ycpss91255/digital_twin/Reference/Capacitor/SMD Capacitor.jpg

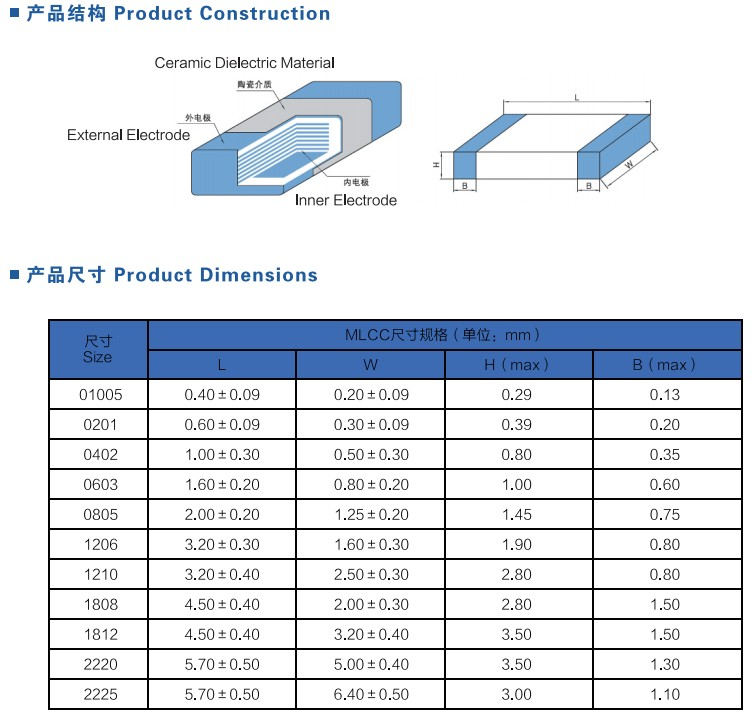
Reference/Capacitor/SMD Capacitor.jpg
