ycpss91255/digital_twin/Reference/header/2.54牛角.jpg

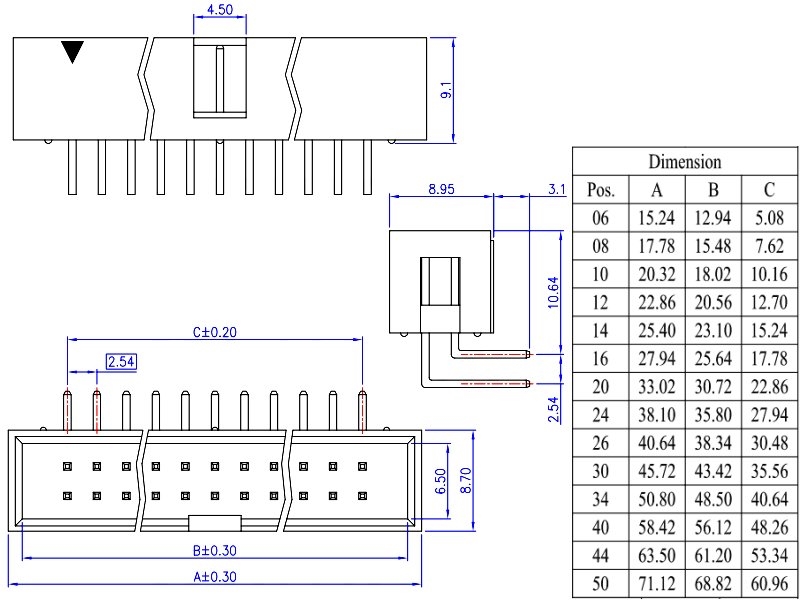
Reference/header/2.54牛角.jpg
