ycpss91255/digital_twin/Reference/header/KF301-2P.jpg

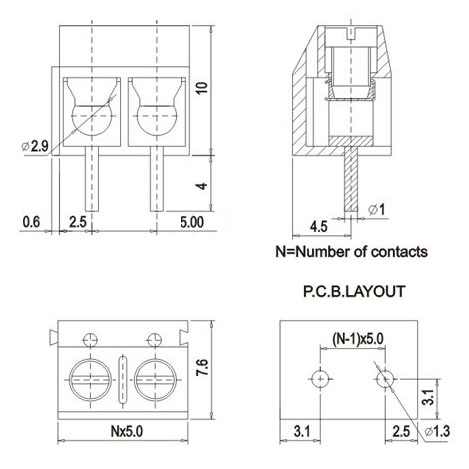
Reference/header/KF301-2P.jpg
