ycpss91255/digital_twin/Reference/Power Supply/XH-M401 非隔離型DC-DC降壓模組/尺寸圖2.png

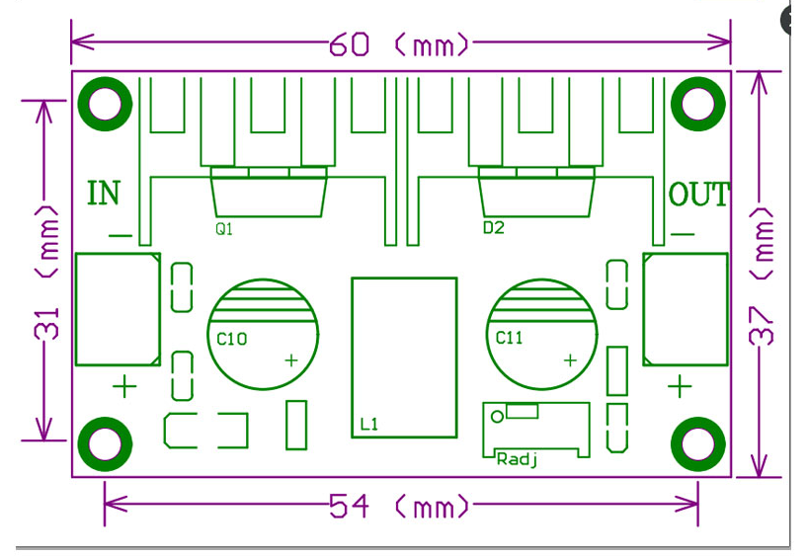
Reference/Power Supply/XH-M401 非隔離型DC-DC降壓模組/尺寸圖2.png
