ycpss91255/digital_twin/Output_PCB/Module_maybe_v2/Main_v1/BOM/Bill of Materials-Main.xlsx

Comment | Description | Designator | Footprint | LibRef | Quantity
220uF | -45℃~+105℃ 2000hrs@105℃ 220uF 7.7mm 25V 6.3mm ±20% SMD,6.3x7.7mm Aluminum Electrolytic Capacitors - SMD ROHS | C1, C2, C7, C8, C11, C13, C14, C19, C20, C21, C22, C29, C30 | VZT221M1ETR-0607 | Cap Pol1 | 13
0.1uF | 50V 100nF X7R ±10% 1210 Multilayer Ceramic Capacitors MLCC - SMD/SMT ROHS | C3, C4, C9, C10, C15, C16, C17, C18, C25, C26, C27, C28, C33, C34, C35, C36 | 1210B104K500NT | Cap Semi | 16
10F | CAPACITOR 10F -10% +30% 5.5V T/H | C5, C6 | SUPPYCAP-DIP_L33.0_W16.5 | Cap Pol1 | 2
0.1uF | 25V 100nF X7R ±10% 0603 Multilayer Ceramic Capacitors MLCC - SMD/SMT ROHS | C12, C23, C24, C31, C32 | CL10B104KA8NNNC | Cap Semi | 5
LED(G) | Green-yellow 0603 Light Emitting Diodes (LED) RoHS | D1, D2 | BL-HG036D-AV-TRB | LED0 | 2
De0-Nano | DE0-Nano | De0 | DE0-Nano | De0-Nano | 1
De10-Nano | De10-Nano | De10 | De10-Nano | De10-Nano | 1
5A Fuse Holder | 01550900M (Fuse Holder) SMD,9.73x5.03mm Fuse Holders ROHS ----- 0451005.MRL (Fuse) FastBlow 50A SMD Fuse 5A 5.566 12.5mΩ SMD Fuses ROHS | F1 | SMD Fuses Holder | Fuse 1 | 1
10A Fuse Holder | 01550900M (Fuse Holder) SMD,9.73x5.03mm Fuse Holders ROHS ----- 0451010.MRL (Fuse) FastBlow 50A SMD Fuse 10A 26.46 5.6mΩ SMD Fuses ROHS | F2 | SMD Fuses Holder | Fuse 1 | 1
4A Fuse Holder | 01550900M (Fuse Holder) SMD,9.73x5.03mm Fuse Holders ROHS ----- 0451004.MRL (Fuse) FastBlow 50A SMD Fuse 4A 3.152 16mΩ SMD Fuses ROHS | F3, F4 | SMD Fuses Holder | Fuse 1 | 2
DC-005-T25 | Shrouded DC Power Receptacle -10℃~+60℃ 2.5mm 6.3mm 3A 30V Plugin AC/DC Power Connectors ROHS | J1 | DC-005-T25 | PWR2.5 | 1
M3 Hole | M3 Hole | MH1, MH2, MH3, MH4, MH5, MH6, MH7, MH8, MH9 | M3 Hole | M3_Hole | 9
Header 2 | XT60PW-F 500V 45A Through Hole Power Connectors ROHS | P1 | XT60PW-F | Header 2 | 1
Header 2 | 1x2P XH 1 2.5mm 2 Brass Plugin,P=2.5mm Wire To Board / Wire To Wire Connector ROHS | P2, P3, P4 | B2B-XH-A(LF)(SN) | Header 2 | 3
Header 3 | 1x3P XH 1 2.5mm 3 Brass Plugin,P=2.5mm Wire To Board / Wire To Wire Connector ROHS | P5 | B3B-XH-A(LF)(SN) | Header 3 | 1
MPU9250 | 9DOF, 3 Axis Gyro, Acceleration, Magmetic | P6 | MPU9250 | MPU9250 | 1
Header 7 | 3A Straight Square Pins 2.5mm 6mm -40℃~+105℃ 1 7 3mm 2.54mm Black 1x7P Plugin,P=2.54mm Pin Headers ROHS | P7, P9 | KH-2.54FH-1X7P-H8.5 | Header 7 | 2
Header 4 | 3A Straight Square Pins 2.5mm 6mm -40℃~+105℃ 1 4 3mm 2.54mm Black 1x4P Plugin,P=2.54mm Pin Headers ROHS | P8, P10 | KH-2.54FH-1X4P-H8.5 | Header 4 | 2
Header 12 | 3A Straight Square Pins 2.5mm 6mm -40℃~+105℃ 1 12 3mm 2.54mm Black 1x12P Plugin,P=2.54mm Pin Headers ROHS | P11, P12 | KH-2.54FH-1X12P-H8.5 (Pad Linked) | Header 12 | 2
Header 6 | 1x6P XH 1 2.5mm 6 Brass Plugin,P=2.5mm Wire To Board / Wire To Wire Connector ROHS | P13, P14, P15, P16 | B6B-XH-A(LF)(SN) | Header 6 | 4
150k | 100mW 50V ±1% ±100ppm/℃ -55℃~+155℃ 150kΩ 0603 Chip Resistor - Surface Mount ROHS | R1, R3 | RS-03K1503FT | Res1 | 2
1k | 100mW 50V ±1% ±100ppm/℃ -55℃~+155℃ 150kΩ 0603 Chip Resistor - Surface Mount ROHS | R2, R5, R6 | RS-03K1503FT | Res1 | 3
12 | Metal Oxide Resistors 12Ω 3W ±700ppm/℃ ±5% Axial Leaded Through Hole Resistors ROHS | R4 | MOF3WS-12Ω±5%T | Res1 | 1
Rasbperry PI 4 |  | RPi1 | Raspberry Pi 4 | Rasbperry PI 4 | 1
Motor EMS | JNQ032 (Header) 30A Short Connection Quick connect terminal Plugin Cold-pressed?Terminals ROHS ----- RT-S02-113-R42BR (Switch) Through Hole Rocker Switches ROHS | S1 | JNQ032 | SW-SPST | 1
Digital EMS | Cylindrical button handle 125V -25℃~85℃ SPDT PCPin 40000 3A Plugin Toggle Switches ROHS | S2 | ST-0-102-C03-N003-RS | SW-SPDT | 1
FPGA_Re | 6.2mm 3.1mm Round Button 50mA Brick nogging 6.5mm SPST 12V SMD Tactile Switches ROHS | S3 | SKHMQLE010 | SW-SPST | 1
RPi_Re | 6.2mm 3.1mm Round Button 50mA Brick nogging 6.5mm SPST 12V SMD Tactile Switches ROHS | S4 | SKHMQKE010 | SW-SPST | 1
XL4015 Module | XL4015E1 (Module) Step-down type TO-263-5 DC-DC Converters ROHS ----- A2541HWV-2x2P (Header) 2.54mm 2.54mm Gold Brass Straight 2x2P 4 2 Plugin,P=2.54mm Female Headers ROHS | T1 | XL4015 Voltage Regulator Module | Non-isolated Voltage regulator | 1
XL4016 Module | NO Step-down type 1 Step-down 1.25V~36V 8V~40V 8A 180kHz TO-220-5 DC-DC Converters ROHS | T2 | XH-M401 Voltage Regulator Module | Non-isolated Voltage regulator | 1
3P3 Voltage regulator | 3A Non-isolated Voltage Regulator | T3 | Small Voltage regulator module | Non-isolated Voltage regulator | 1
HSM3214 | 30V 10A 12mΩ@10V,8A 1.5W 2.5V@250μA 2 N-Channel SOP-8 MOSFETs ROHS | U1, U2 | HSM3214 | HSM3214 | 2
