ycpss91255/digital_twin/Output_PCB/Module_maybe_v2/Main_v1/ExportSTEP/Main.step

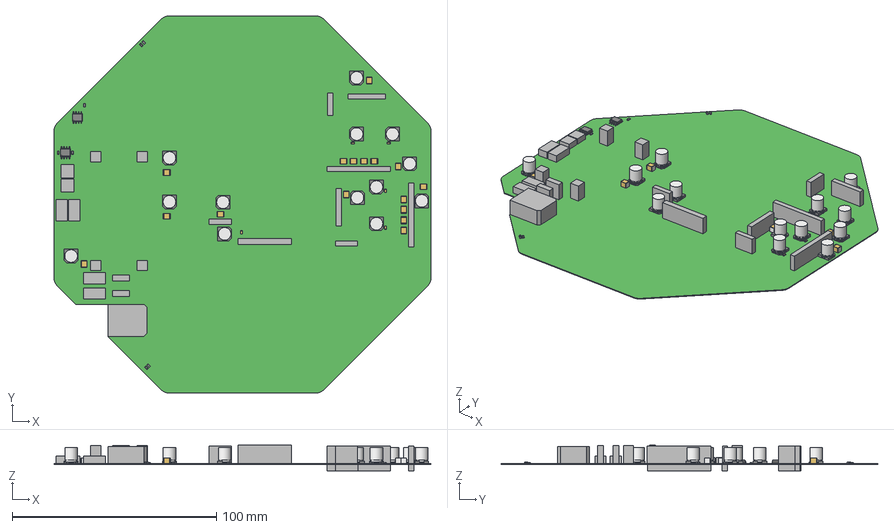
[picture p9: CAD file, 2023-05-25]
Output_PCB/Module_maybe_v2/Main_v1/ExportSTEP/Main.step
184.8 x 184.8 x 12.7 mm
Open_CASCADE_STEP_translator_6.8_25.1.1 x 13
Open_CASCADE_STEP_translator_6.8_25.2.1 x 13
Open_CASCADE_STEP_translator_6.8_25.3.1 x 13
lead x 26
Open_CASCADE_STEP_translator_6.8_7.1.1 x 16
Open_CASCADE_STEP_translator_6.8_7.1.2 x 16
Open_CASCADE_STEP_translator_6.8_7.2.1 x 16
Open_CASCADE_STEP_translator_6.8_3.1.1 x 5
Open_CASCADE_STEP_translator_6.8_3.1.2 x 5
Open_CASCADE_STEP_translator_6.8_3.2.1 x 5
Open_CASCADE_STEP_translator_6.8_14.1.1 x 2
Open_CASCADE_STEP_translator_6.8_14.1.2 x 2
Open_CASCADE_STEP_translator_6.8_14.2.1 x 2
Extruded x 27
Mid_Body x 5
Open_CASCADE_STEP_translator_6.8_10.2.1 x 10
Mark x 5
Open_CASCADE_STEP_translator_6.8_17.1 x 2
Open_CASCADE_STEP_translator_6.8_17.2.1 x 2
Leader x 16
