ycpss91255/digital_twin/Output_PCB/integration_v1/Folder Structure/ExportSTEP/Top.step

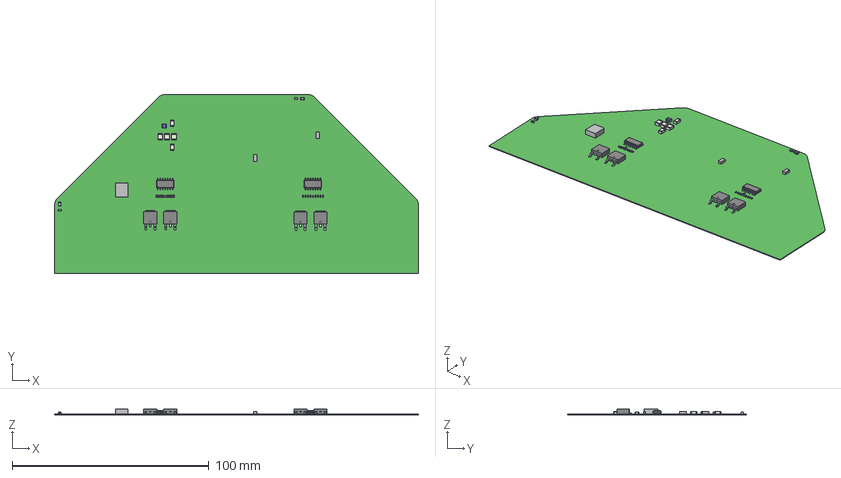
[picture p10: CAD file, 2023-02-23]
Output_PCB/integration_v1/Folder Structure/ExportSTEP/Top.step
184.8 x 90.9 x 3.03 mm
Extruded x 32
Open_CASCADE_STEP_translator_6.8_12.1 x 4
Open_CASCADE_STEP_translator_6.8_12.2.1 x 36
Lead x 8
Trimmed_Lead x 4
tab x 4
Mid_Body x 16
Mark x 16
Open_CASCADE_STEP_translator_6.8_20.1 x 2
Open_CASCADE_STEP_translator_6.8_20.2.1 x 2
Leader x 28
term1
term2
