ycpss91255/digital_twin/Power/USB-C Power/Project Outputs for USB-C Power/v1/ExportSTEP/USB-C Power.step

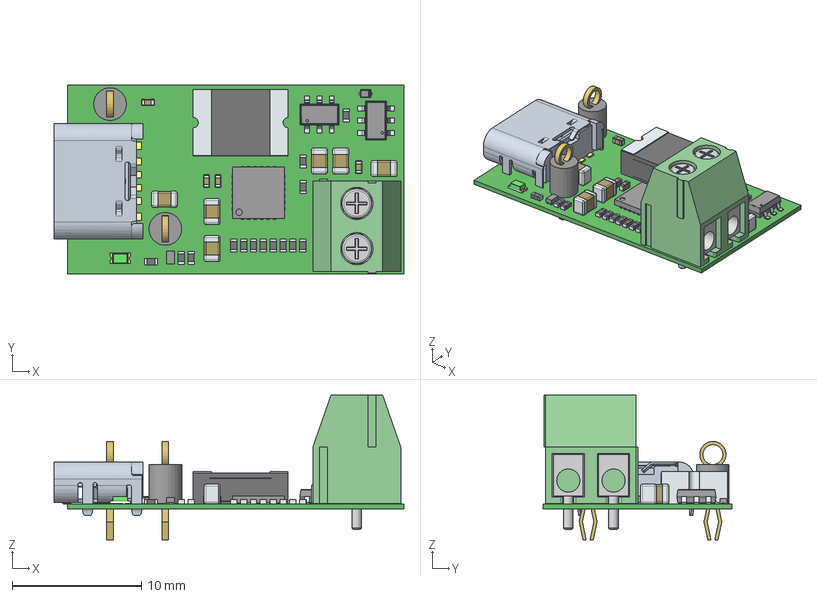
[picture p12: CAD file, 2023-06-17]
Power/USB-C Power/Project Outputs for USB-C Power/v1/ExportSTEP/USB-C Power.step
27.1 x 14.6 x 11.2 mm
PinsArrayLR x 3
term1 x 14
term2 x 14
Pins
Screw_Terminal_Block_3.5mm_2-way
ThermalPin
PinsArrayTB
Rect6
Rect7
solidBody
Terminal
PinKIdent
PinK
PinA
