ycpss91255/digital_twin/Output_PCB/Module_maybe_v2/MotorCtrl_v1/ExportSTEP/MotorCtrl.step

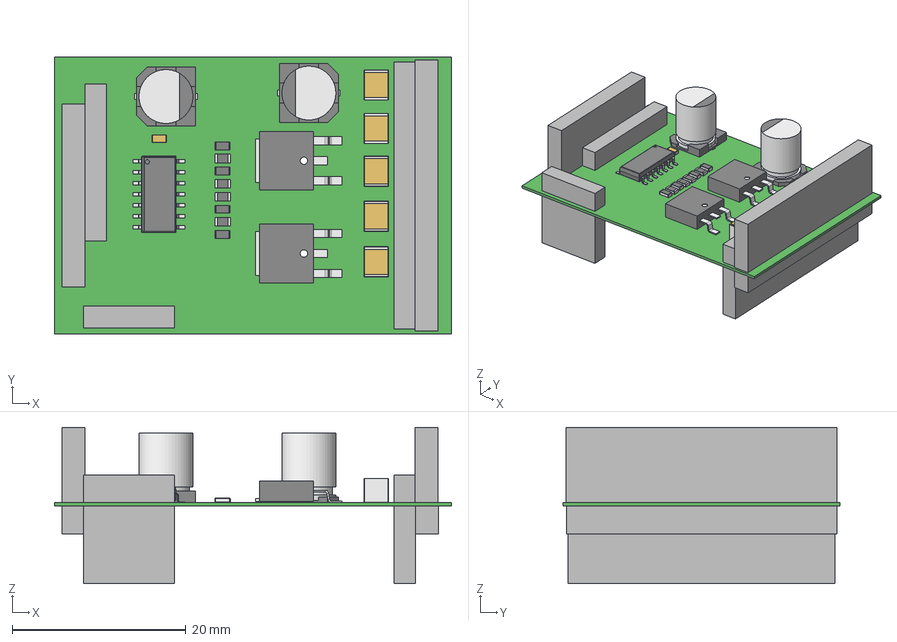
[picture p13: CAD file, 2023-05-25]
Output_PCB/Module_maybe_v2/MotorCtrl_v1/ExportSTEP/MotorCtrl.step
45.7 x 31.9 x 18.0 mm
Open_CASCADE_STEP_translator_6.8_7.1.1 x 5
Open_CASCADE_STEP_translator_6.8_7.1.2 x 5
Open_CASCADE_STEP_translator_6.8_7.2.1 x 5
Open_CASCADE_STEP_translator_6.8_12.1 x 2
Open_CASCADE_STEP_translator_6.8_12.2.1 x 2
Lead x 4
Trimmed_Lead x 2
tab x 2
Open_CASCADE_STEP_translator_6.8_20.1
Open_CASCADE_STEP_translator_6.8_20.2.1
Leader x 14
Open_CASCADE_STEP_translator_6.8_25.1.1 x 2
Open_CASCADE_STEP_translator_6.8_25.2.1 x 2
Open_CASCADE_STEP_translator_6.8_25.3.1 x 2
lead x 4
Open_CASCADE_STEP_translator_6.8_3.1.1
Open_CASCADE_STEP_translator_6.8_3.1.2
Open_CASCADE_STEP_translator_6.8_3.2.1
Extruded x 10
Mid_Body x 8
Open_CASCADE_STEP_translator_6.8_1.2.1 x 8
Mark x 8
Open_CASCADE_STEP_translator_6.8_2.2.1 x 8
