ycpss91255/digital_twin/old_data/Reference/partition_Temp.DXF

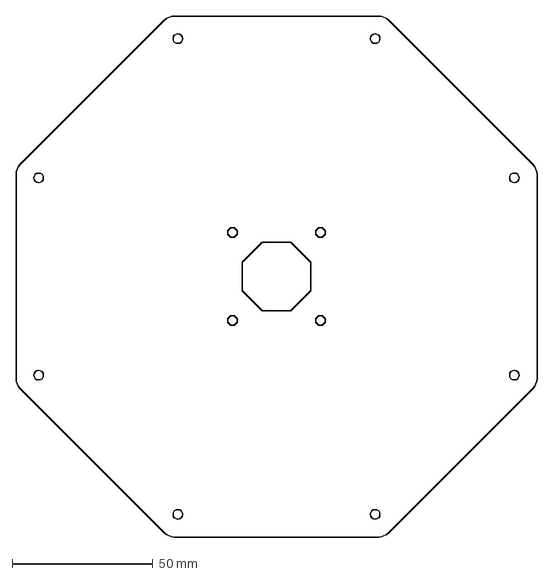
[picture p14: CAD file, 2023-02-23, an earlier design]
old_data/Reference/partition_Temp.DXF
184.8 x 184.8 mm
