ycpss91255/digital_twin/(list of files, cad)

Other CAD files:
OWMR/Project Outputs for OWMR/Output_v1/Folder Structure/ExportSTEP/Top.step
old_data/Reference/partition_Temp_20mm.DWG
