ycpss91255/digital_twin/Output_PCB/Module_maybe_v2/Main_v1/Schematic Print/Schematic Prints.PDF

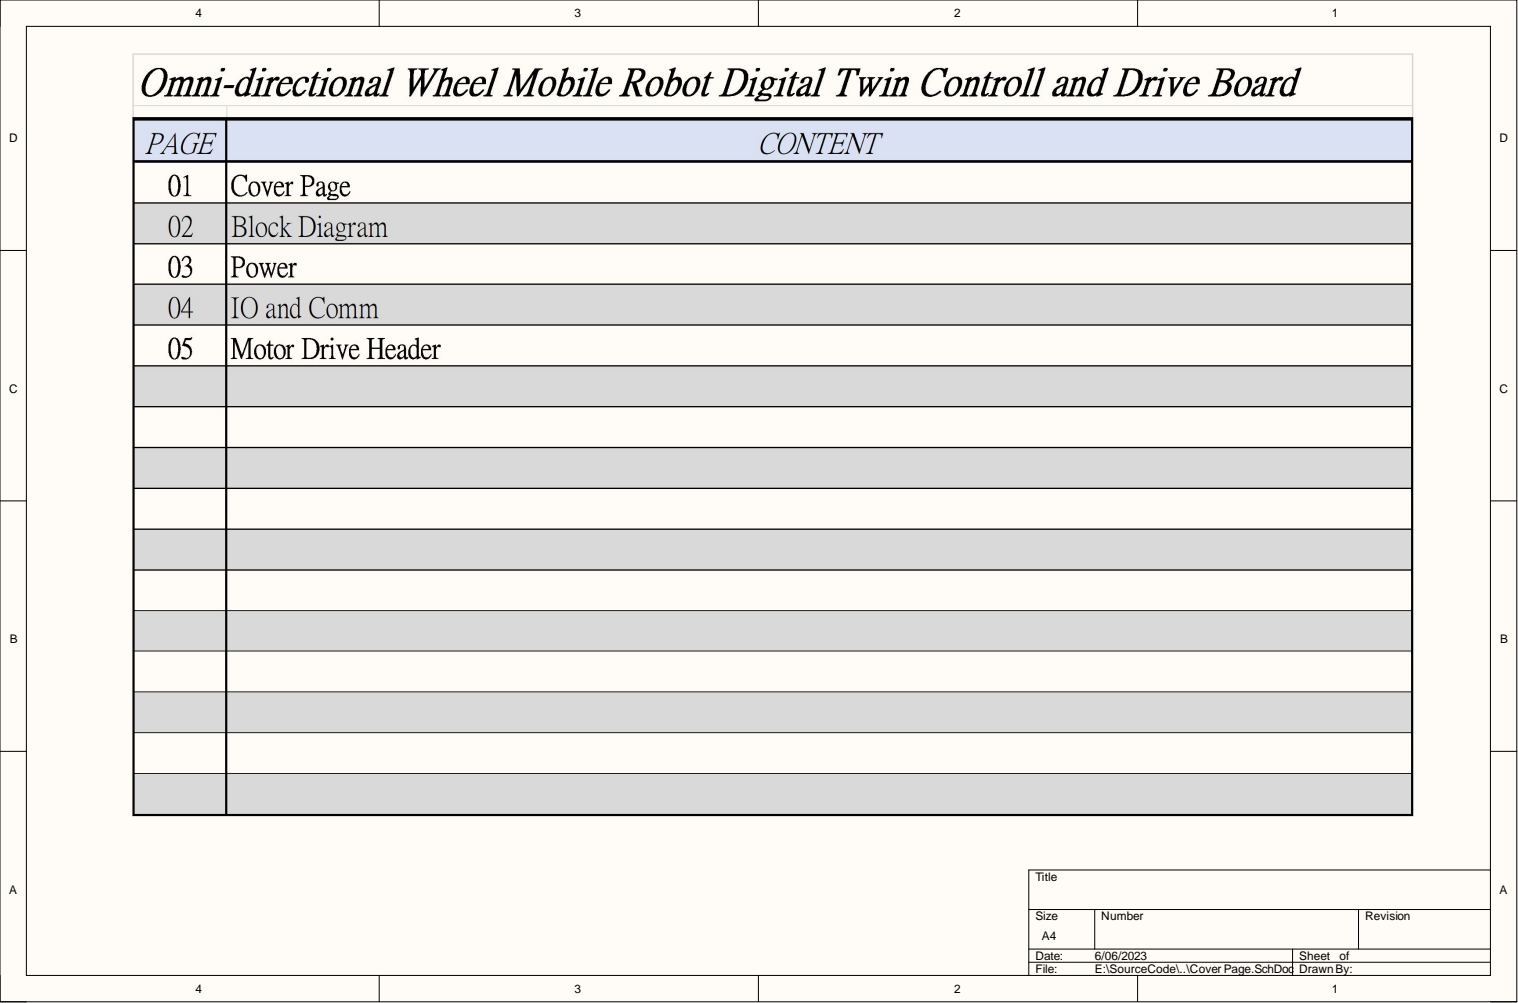
[picture p15: page 1]

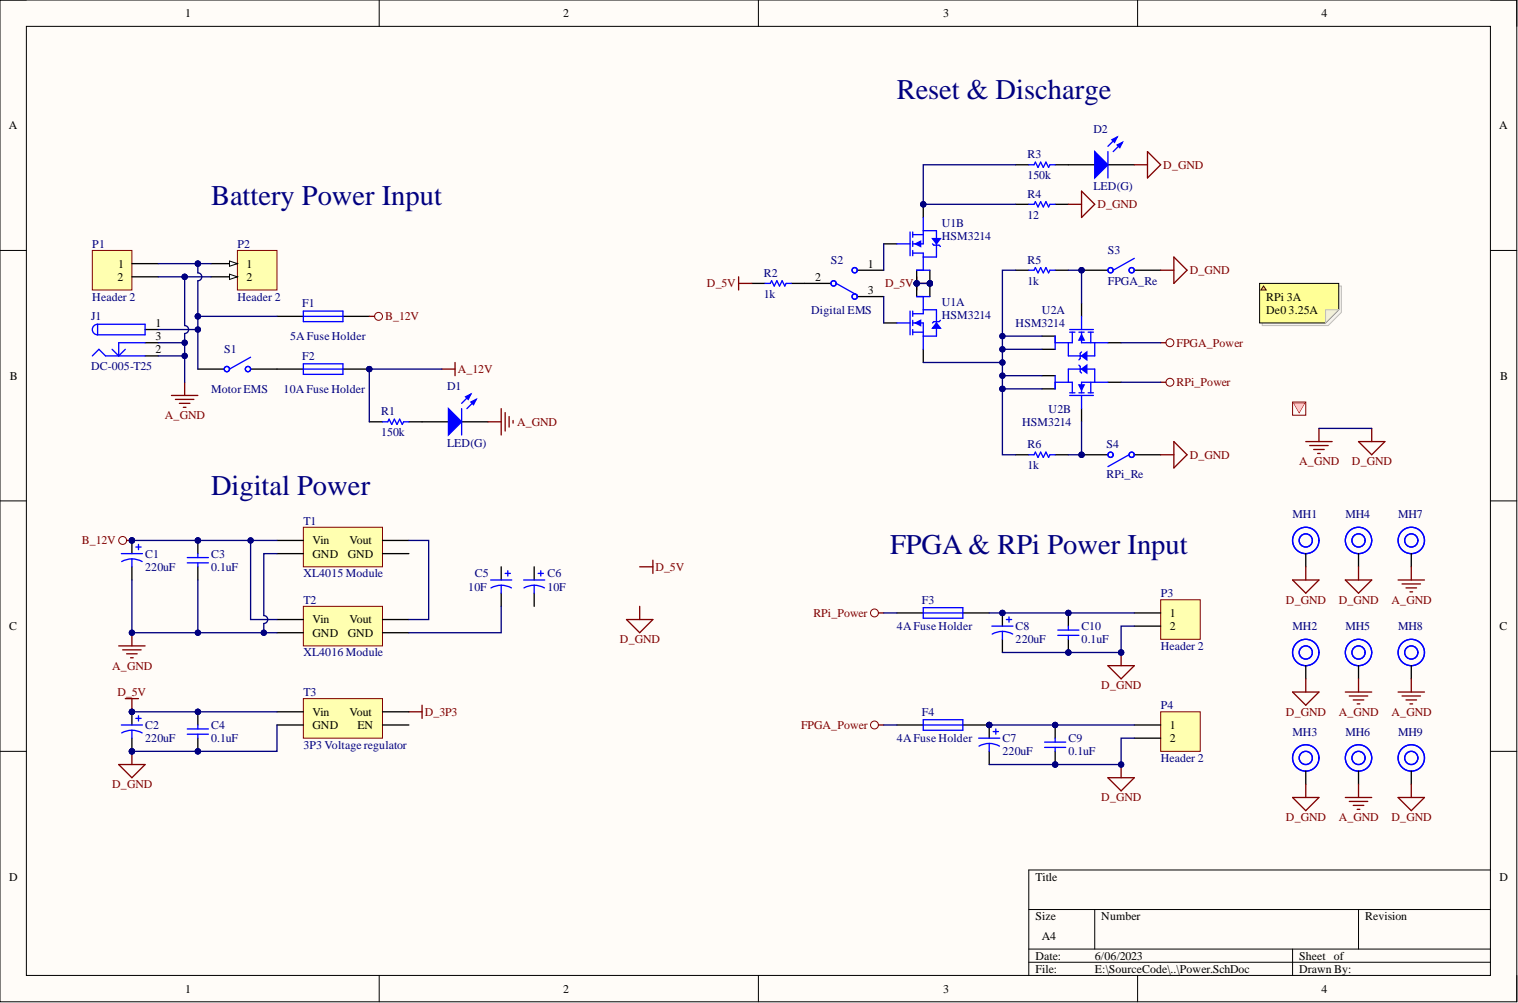
[picture p16: page 2]

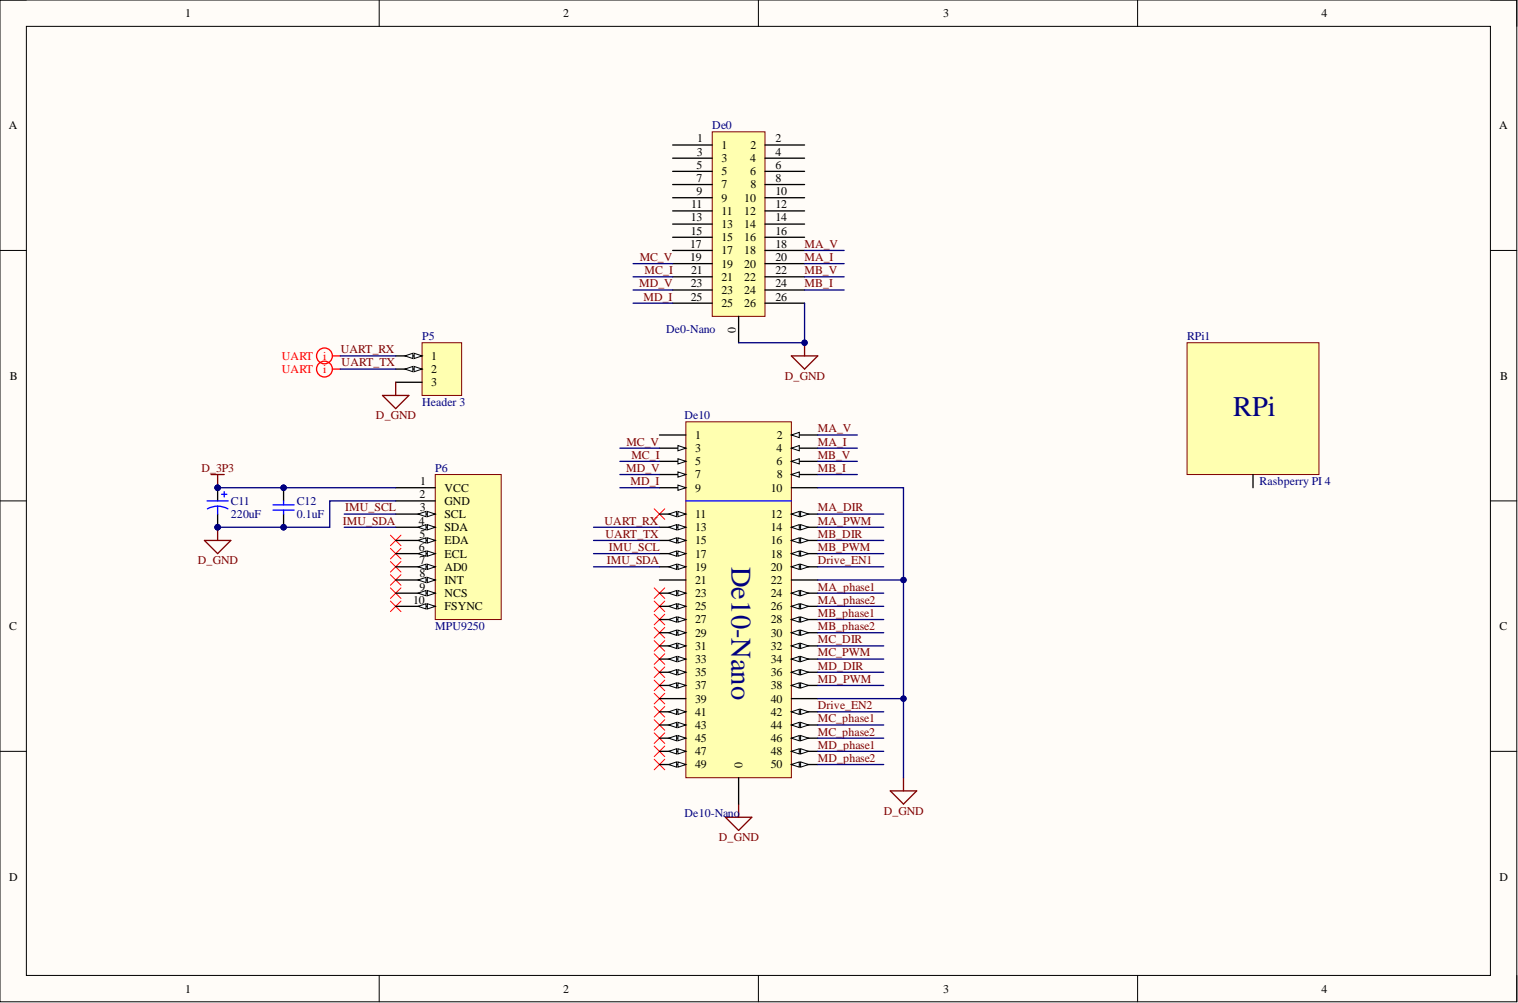
[picture p17: page 3]

MA _ D IR MA _PW M MB_ D IR MB_PW M Dri ve_ E N 1

MA _ p h a s e 1 MA _ p h a s e 2 MB_ p has e 1 MB_ p has e 2 MC_ D IR MC_PW M MD _ D IR MD _PW M

Dri ve_ E N 2 MC_ p has e 1 MC_ p has e 2 MD _ p h a s e 1 MD _ p h a s e 2

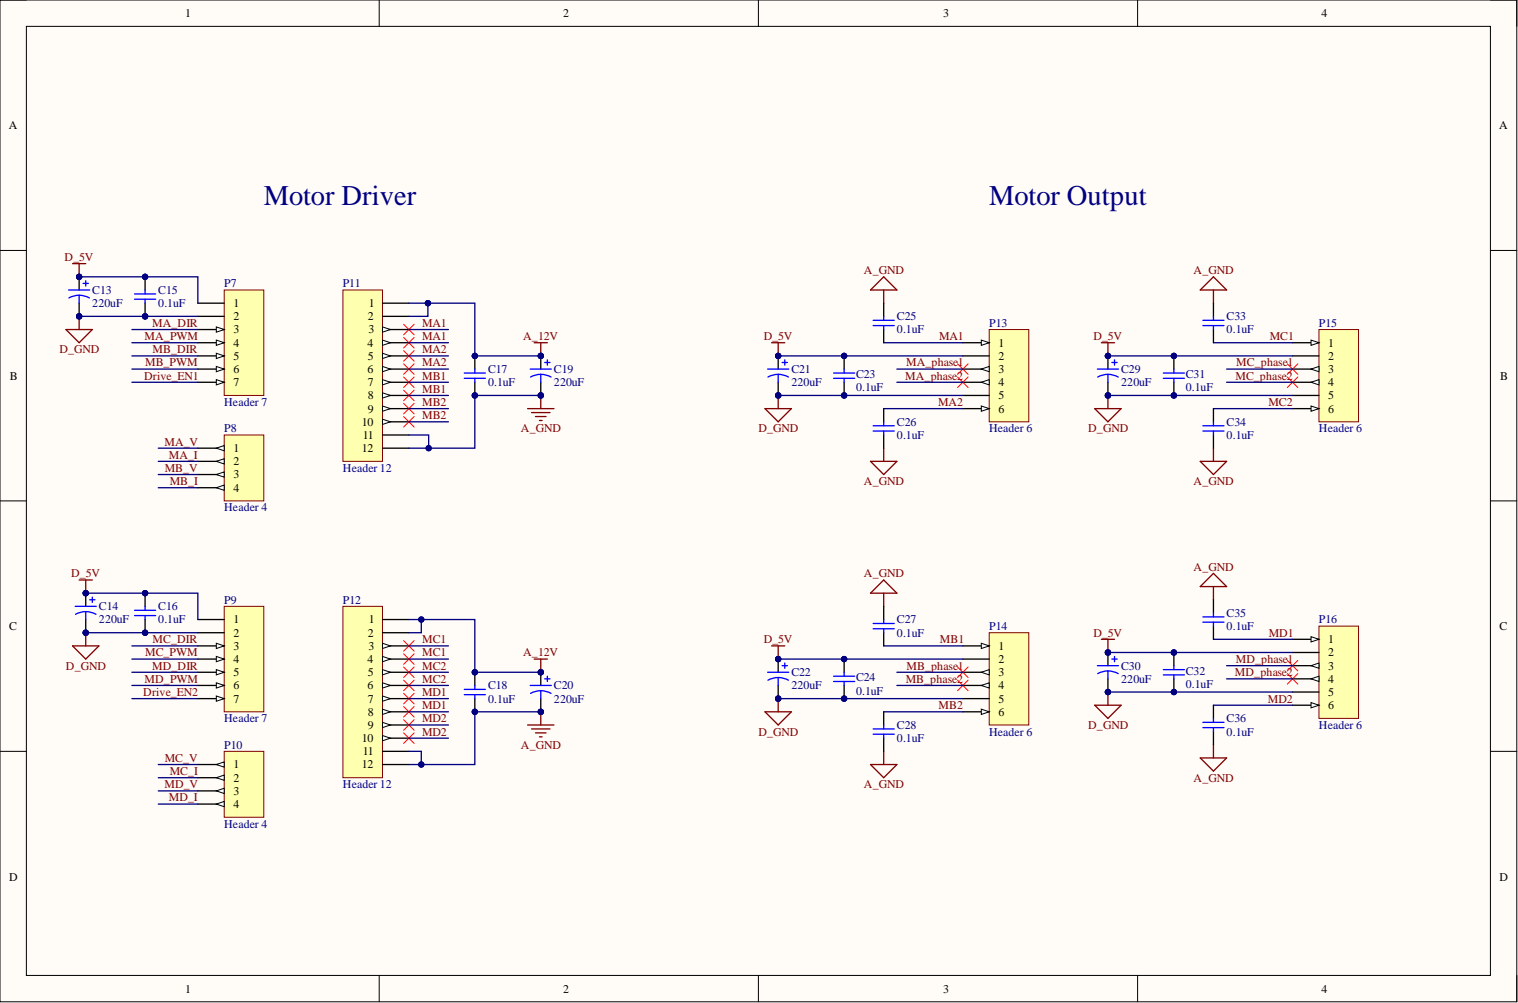
[picture p18: page 4]
