ycpss91255/digital_twin/Power/USB-C Power/Project Outputs for USB-C Power/v1/PDF/Schematic Prints.PDF

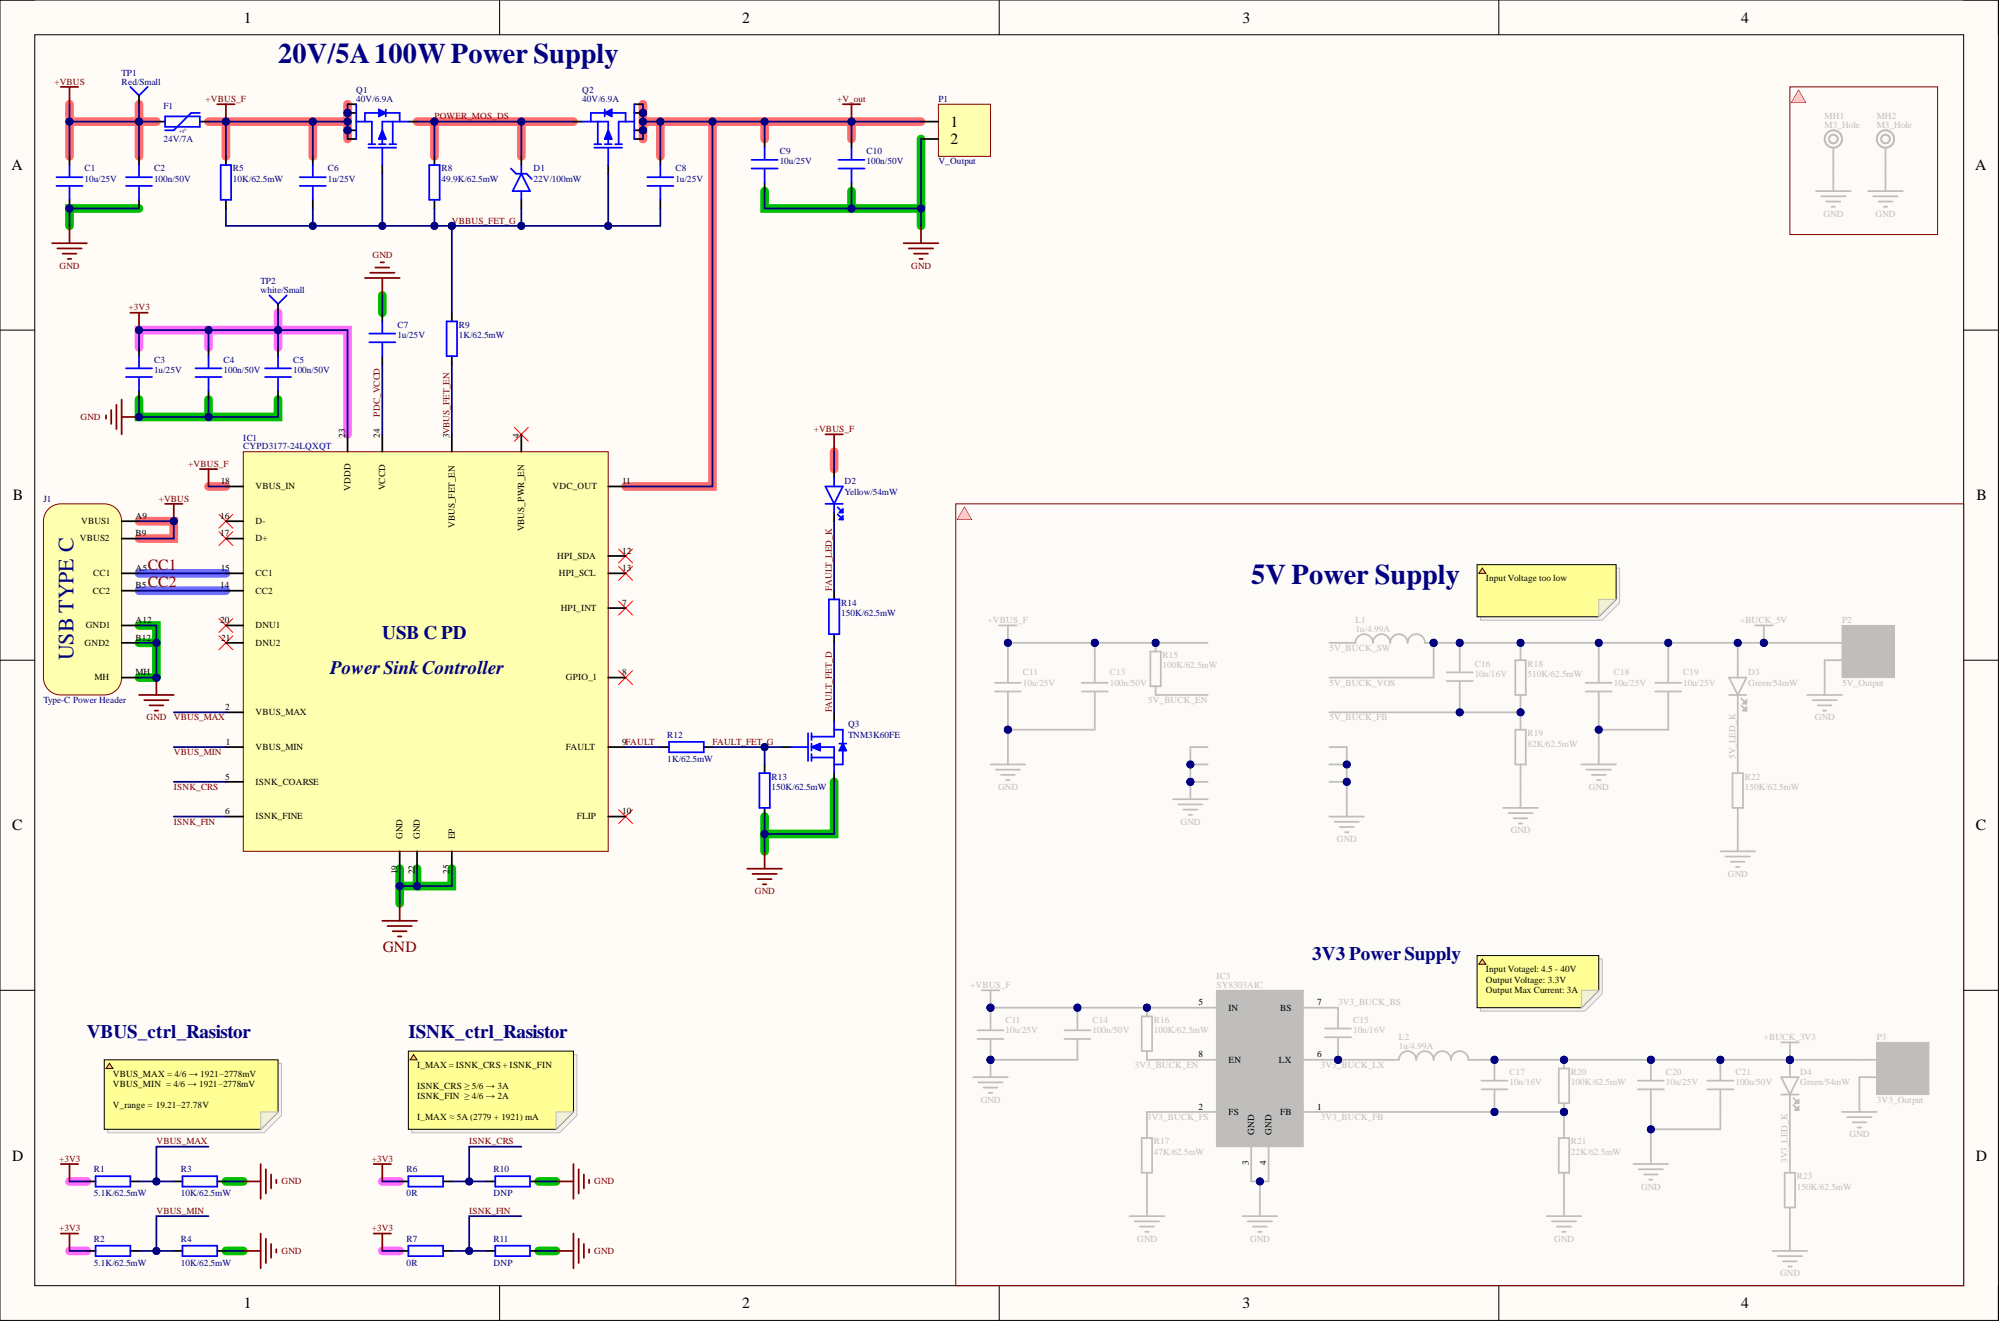
[picture p19: page 1]

Input Voltage too low
