ycpss91255/digital_twin/Output_PCB/integration_v1/數位孿生_Power_電路.pdf

# 【數位孿⽣】Power 電路

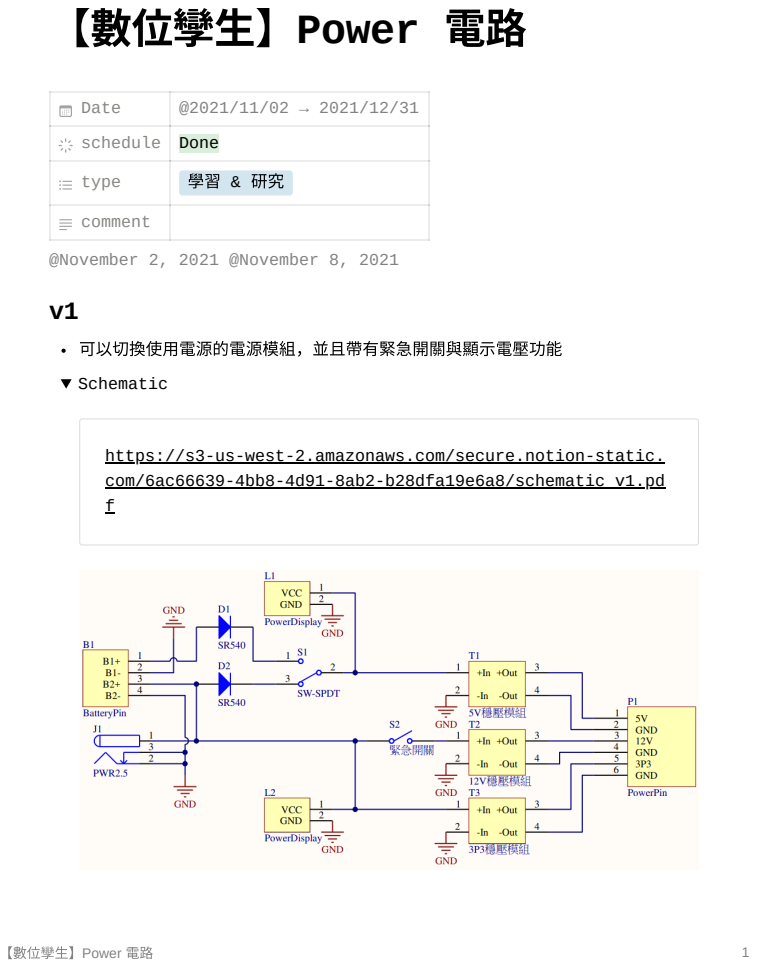
[picture p20: page 1]
【數位孿⽣】Power 電路; @November 2, 2021 @November 8, 2021

Date | @2021/11/02 → 2021/12/31
schedule | Done

type | 學習 & 研究

comment

可以切換使⽤電源的電源模組，並且帶有緊急開關與顯⽰電壓功能
Schematic

https://s3-us-west-2.amazonaws.com/secure.notion-static.
com/6ac66639-4bb8-4d91-8ab2-b28dfa19e6a8/schematic_v1.pd

v2

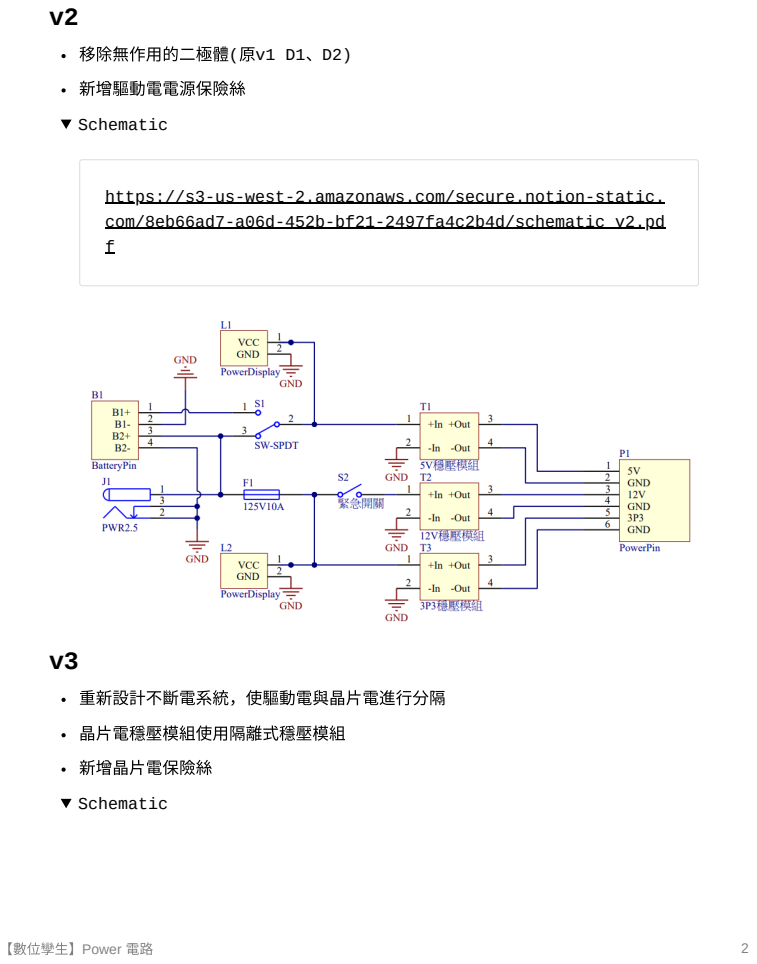
[picture p21: page 2]
移除無作⽤的⼆極體(原v1 D1、D2); 新增驅動電電源保險絲; Schematic; 晶⽚電穩壓模組使⽤隔離式穩壓模組; 新增晶⽚電保險絲

https://s3-us-west-2.amazonaws.com/secure.notion-static.
com/8eb66ad7-a06d-452b-bf21-2497fa4c2b4d/schematic_v2.pd

重新設計不斷電系統，使驅動電與晶⽚電進⾏分隔

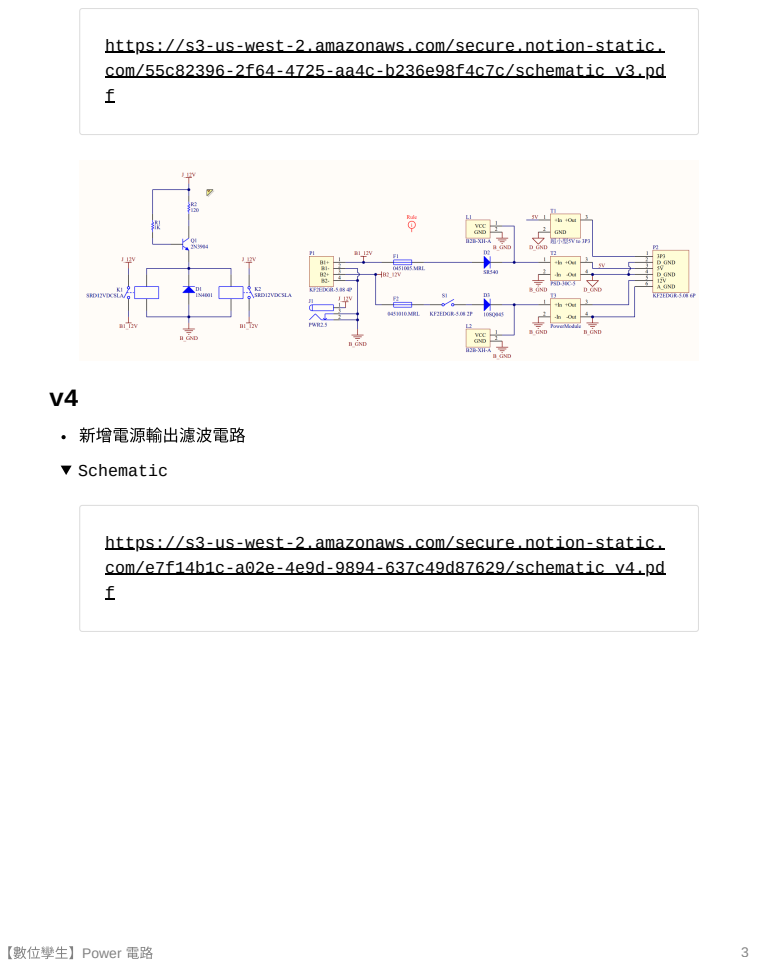
[picture p22: page 3]
新增電源輸出濾波電路; Schematic

https://s3-us-west-2.amazonaws.com/secure.notion-static.
com/55c82396-2f64-4725-aa4c-b236e98f4c7c/schematic_v3.pd

com/e7f14b1c-a02e-4e9d-9894-637c49d87629/schematic_v4.pd

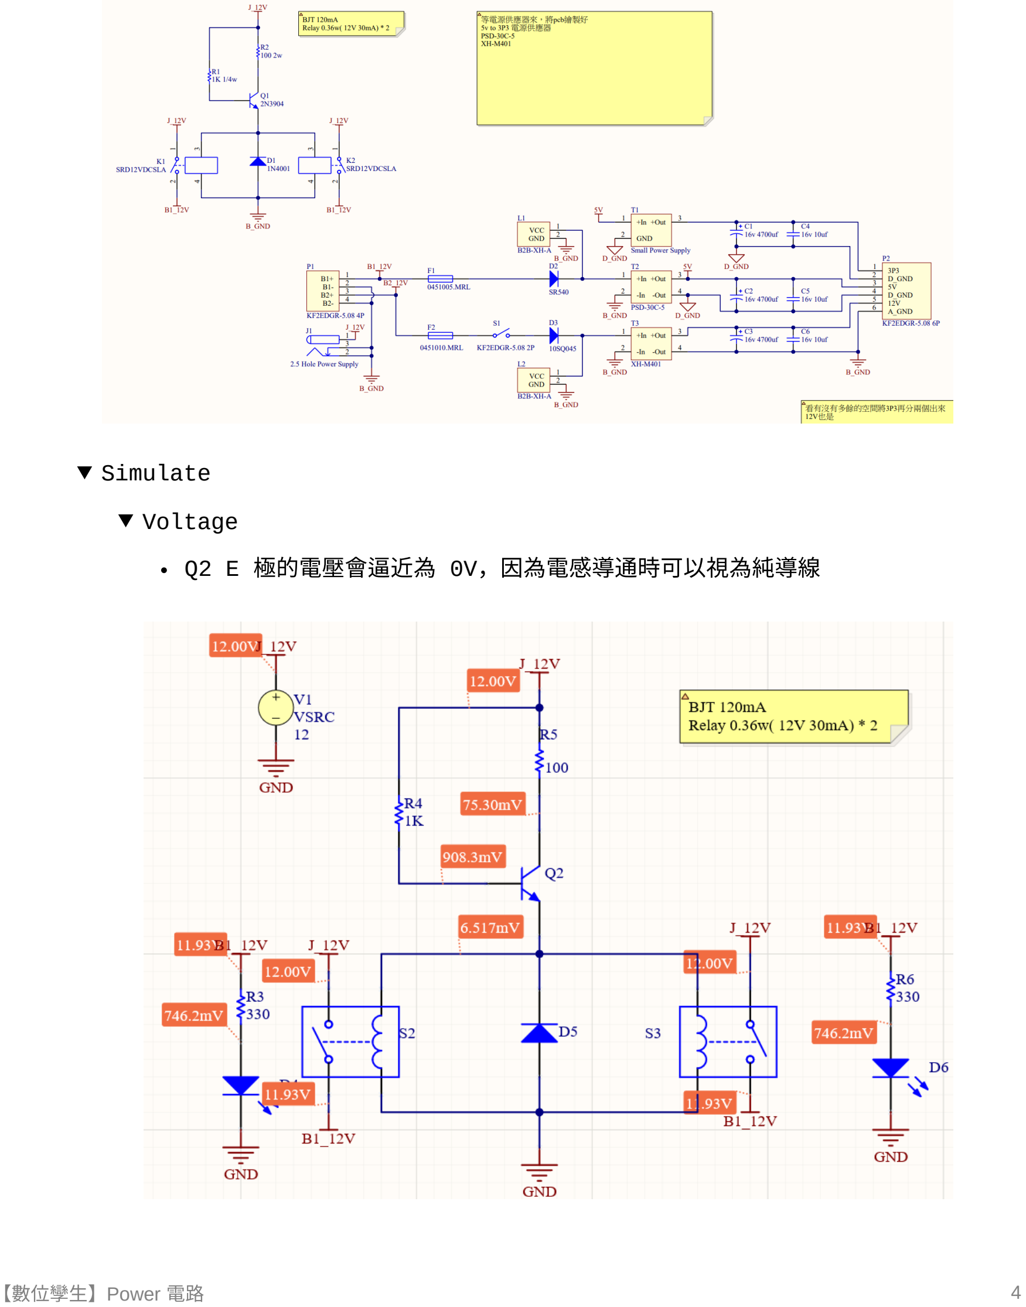
[picture p23: page 4]

Simulate

Voltage

Q2 E 極的電壓會逼近為 0V，因為電感導通時可以視為純導線

### fA = 10⁻¹⁵

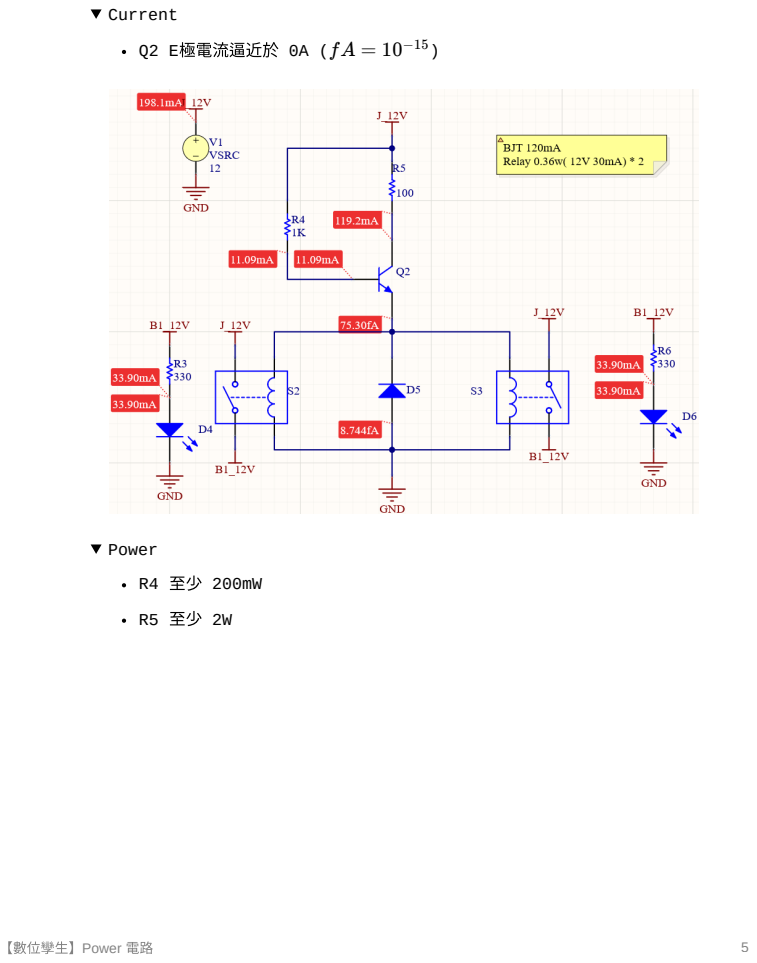
[picture p24: page 5]
Current; Q2 E極電流逼近於 0A (; Power

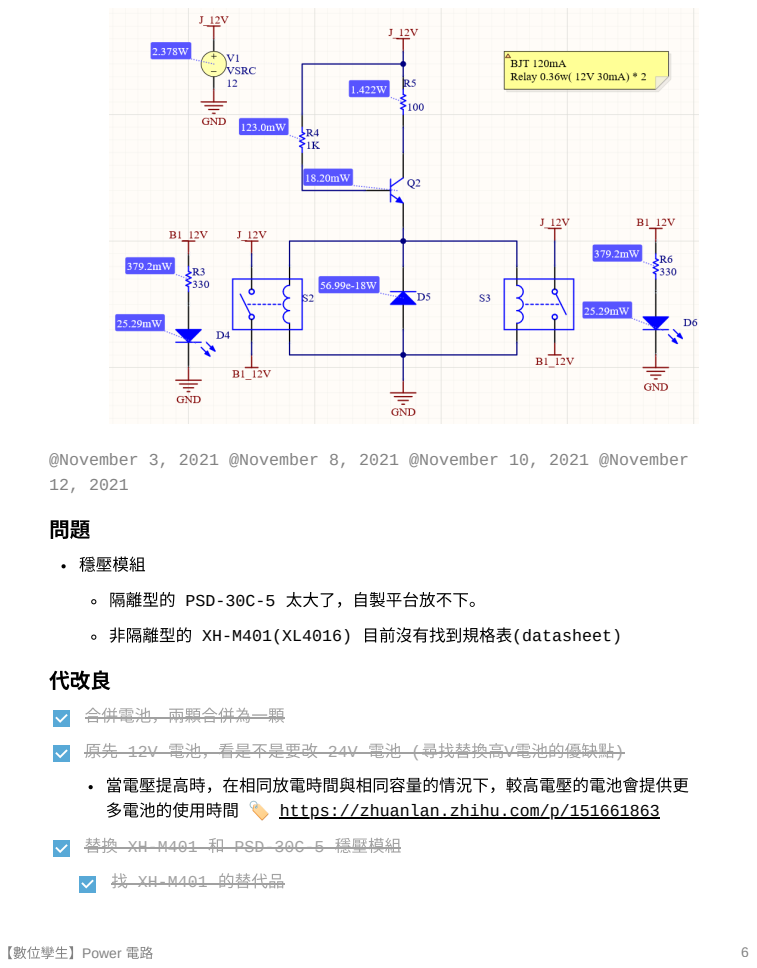
[picture p25: page 6]
穩壓模組; 代改良; 合併電池，兩顆合併為⼀顆

@November 3, 2021 @November 8, 2021 @November 10, 2021 @November

隔離型的 PSD-30C-5 太⼤了，⾃製平台放不下。
⾮隔離型的 XH-M401(XL4016) ⽬前沒有找到規格表(datasheet)

原先 12V 電池，看是不是要改 24V 電池 (尋找替換⾼V電池的優缺點)

當電壓提⾼時，在相同放電時間與相同容量的情況下，較⾼電壓的電池會提供更
多電池的使⽤時間 🏷 https://zhuanlan.zhihu.com/p/151661863

替換 XH-M401 和 PSD-30C-5 穩壓模組
找 XH-M401 的替代品

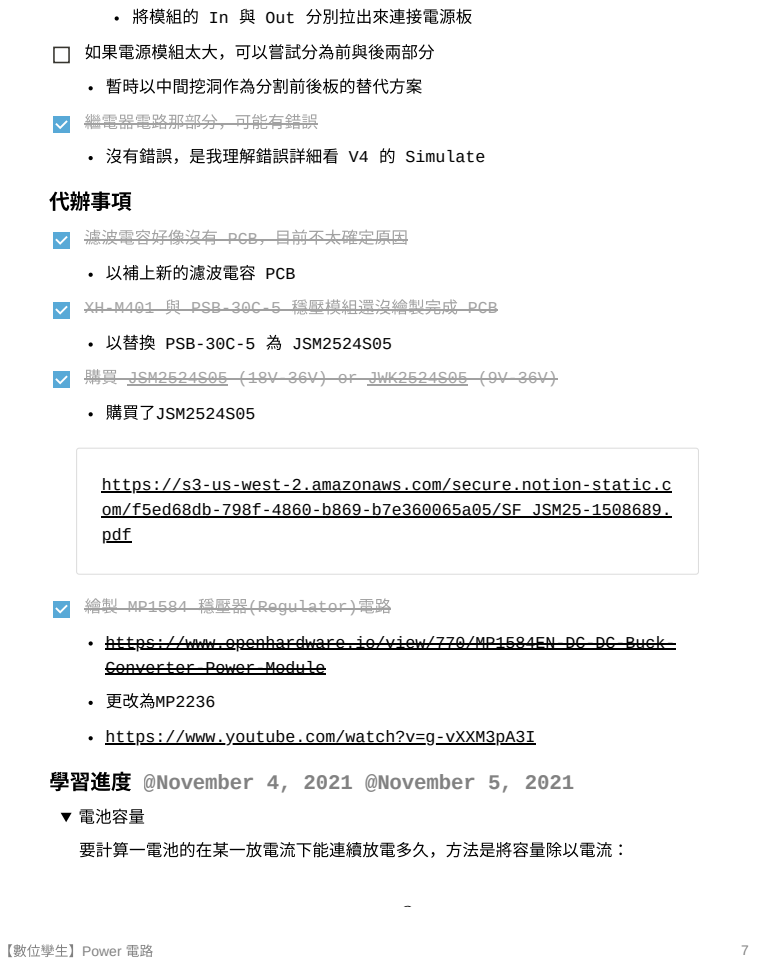
[picture p26: page 7]
如果電源模組太⼤，可以嘗試分為前與後兩部分; 暫時以中間挖洞作為分割前後板的替代⽅案; 代辦事項; 學習進度; 電池容量; 繼電器電路那部分，可能有錯誤

將模組的 In 與 Out 分別拉出來連接電源板

沒有錯誤，是我理解錯誤詳細看 V4 的 Simulate

濾波電容好像沒有 PCB，⽬前不太確定原因

以補上新的濾波電容 PCB
XH-M401 與 PSB-30C-5 穩壓模組還沒繪製完成 PCB
以替換 PSB-30C-5 為 JSM2524S05
購買 JSM2524S05 (https://www.mouser.tw/ProductDetail/XP-Power/JSM2524S05?qs=w%2Fv1CP2dgqr8QvmljjBS0g%3D%3D) (18V-36V) or JWK2524S05 (https://www.mouser.tw/ProductDetail/XP-Power/JWK2524S05?qs=w%2Fv1CP2dgqp80DPt1kfK5Q%3D%3D) (9V-36V)
購買了JSM2524S05

https://s3-us-west-2.amazonaws.com/secure.notion-static.c
om/f5ed68db-798f-4860-b869-b7e360065a05/SF_JSM25-1508689.
pdf (https://www.notion.so/signed/https%3A%2F%2Fs3-us-west-2.amazonaws.com%2Fsecure.notion-static.com%2Ff5ed68db-798f-4860-b869-b7e360065a05%2FSF_JSM25-1508689.pdf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)

繪製 MP1584 穩壓器(Regulator)電路

https://www.openhardware.io/view/770/MP1584EN-DC-DC-Buck-
Converter-Power-Module (https://www.openhardware.io/view/770/MP1584EN-DC-DC-Buck-Converter-Power-Module)
更改為MP2236

https://www.youtube.com/watch?v=g-vXXM3pA3I
@November 4, 2021 @November 5, 2021

要計算⼀電池的在某⼀放電流下能連續放電多久，⽅法是將容量除以電流：

當中，t(h) 是放電時間 (單位是⼩時)、Q(Ah) 是電池容量 (單位是安倍⼩ 時)、I(A) 是電流(安培)。

⽽放電 (或充電) 電流也有⽤ C 值來表述，1個 C 的放電電流會剛好在⼀⼩ 時把電池完全放電，也就是1個C的電流是相對電池容量⽽定。例如⼀枚 600mAh 的電池，1個 C 的電流即是 600mA，以這個電流放電會在⼀⼩時內⽤完電量。 同樣地，對⼀枚 2500mAh 的電池，1C 就是 2500mA。⼜例如以 0.5C 對電 池放電的話，不管電池容量多⼩，電池都會在2⼩時⽤完 (1/0.5=2)。

繼電器+⼆極體

學暫態分析⽅法?

🏷 google (https://www.google.com/search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)

🏷 https://www.ruten.com.tw/item/show?21301263475532

🏷 https://www.eettaiwan.com/20210520nt51-is-diode-neededin-relay/ (https://www.eettaiwan.com/20210520nt51-is-diode-needed-in-relay/)

🏷 https://www.gushiciku.cn/dc_news/tech_ZfvX

🏷 https://www.itread01.com/content/1548731711.html

🏷 https://min.news/zhtw/home/4def66cdab869dd290298614faedf735.html (https://min.news/zh-tw/home/4def66cdab869dd290298614faedf735.html)

https://www.altium.com/documentation/altiumdesigner/mixed-signal-circuit-simulation-ad(重要) (https://www.altium.com/documentation/altium-designer/mixed-signal-circuit-simulation-ad)

購買材料

詢問廠商電⼦零件是否有貨

t =
I

Q

@November 11, 2021

@November 15, 2021
