ycpss91255/digital_twin/Output_PCB/Module_maybe_v2/Main_v1/PCB Print/Assembly Drawings.PDF

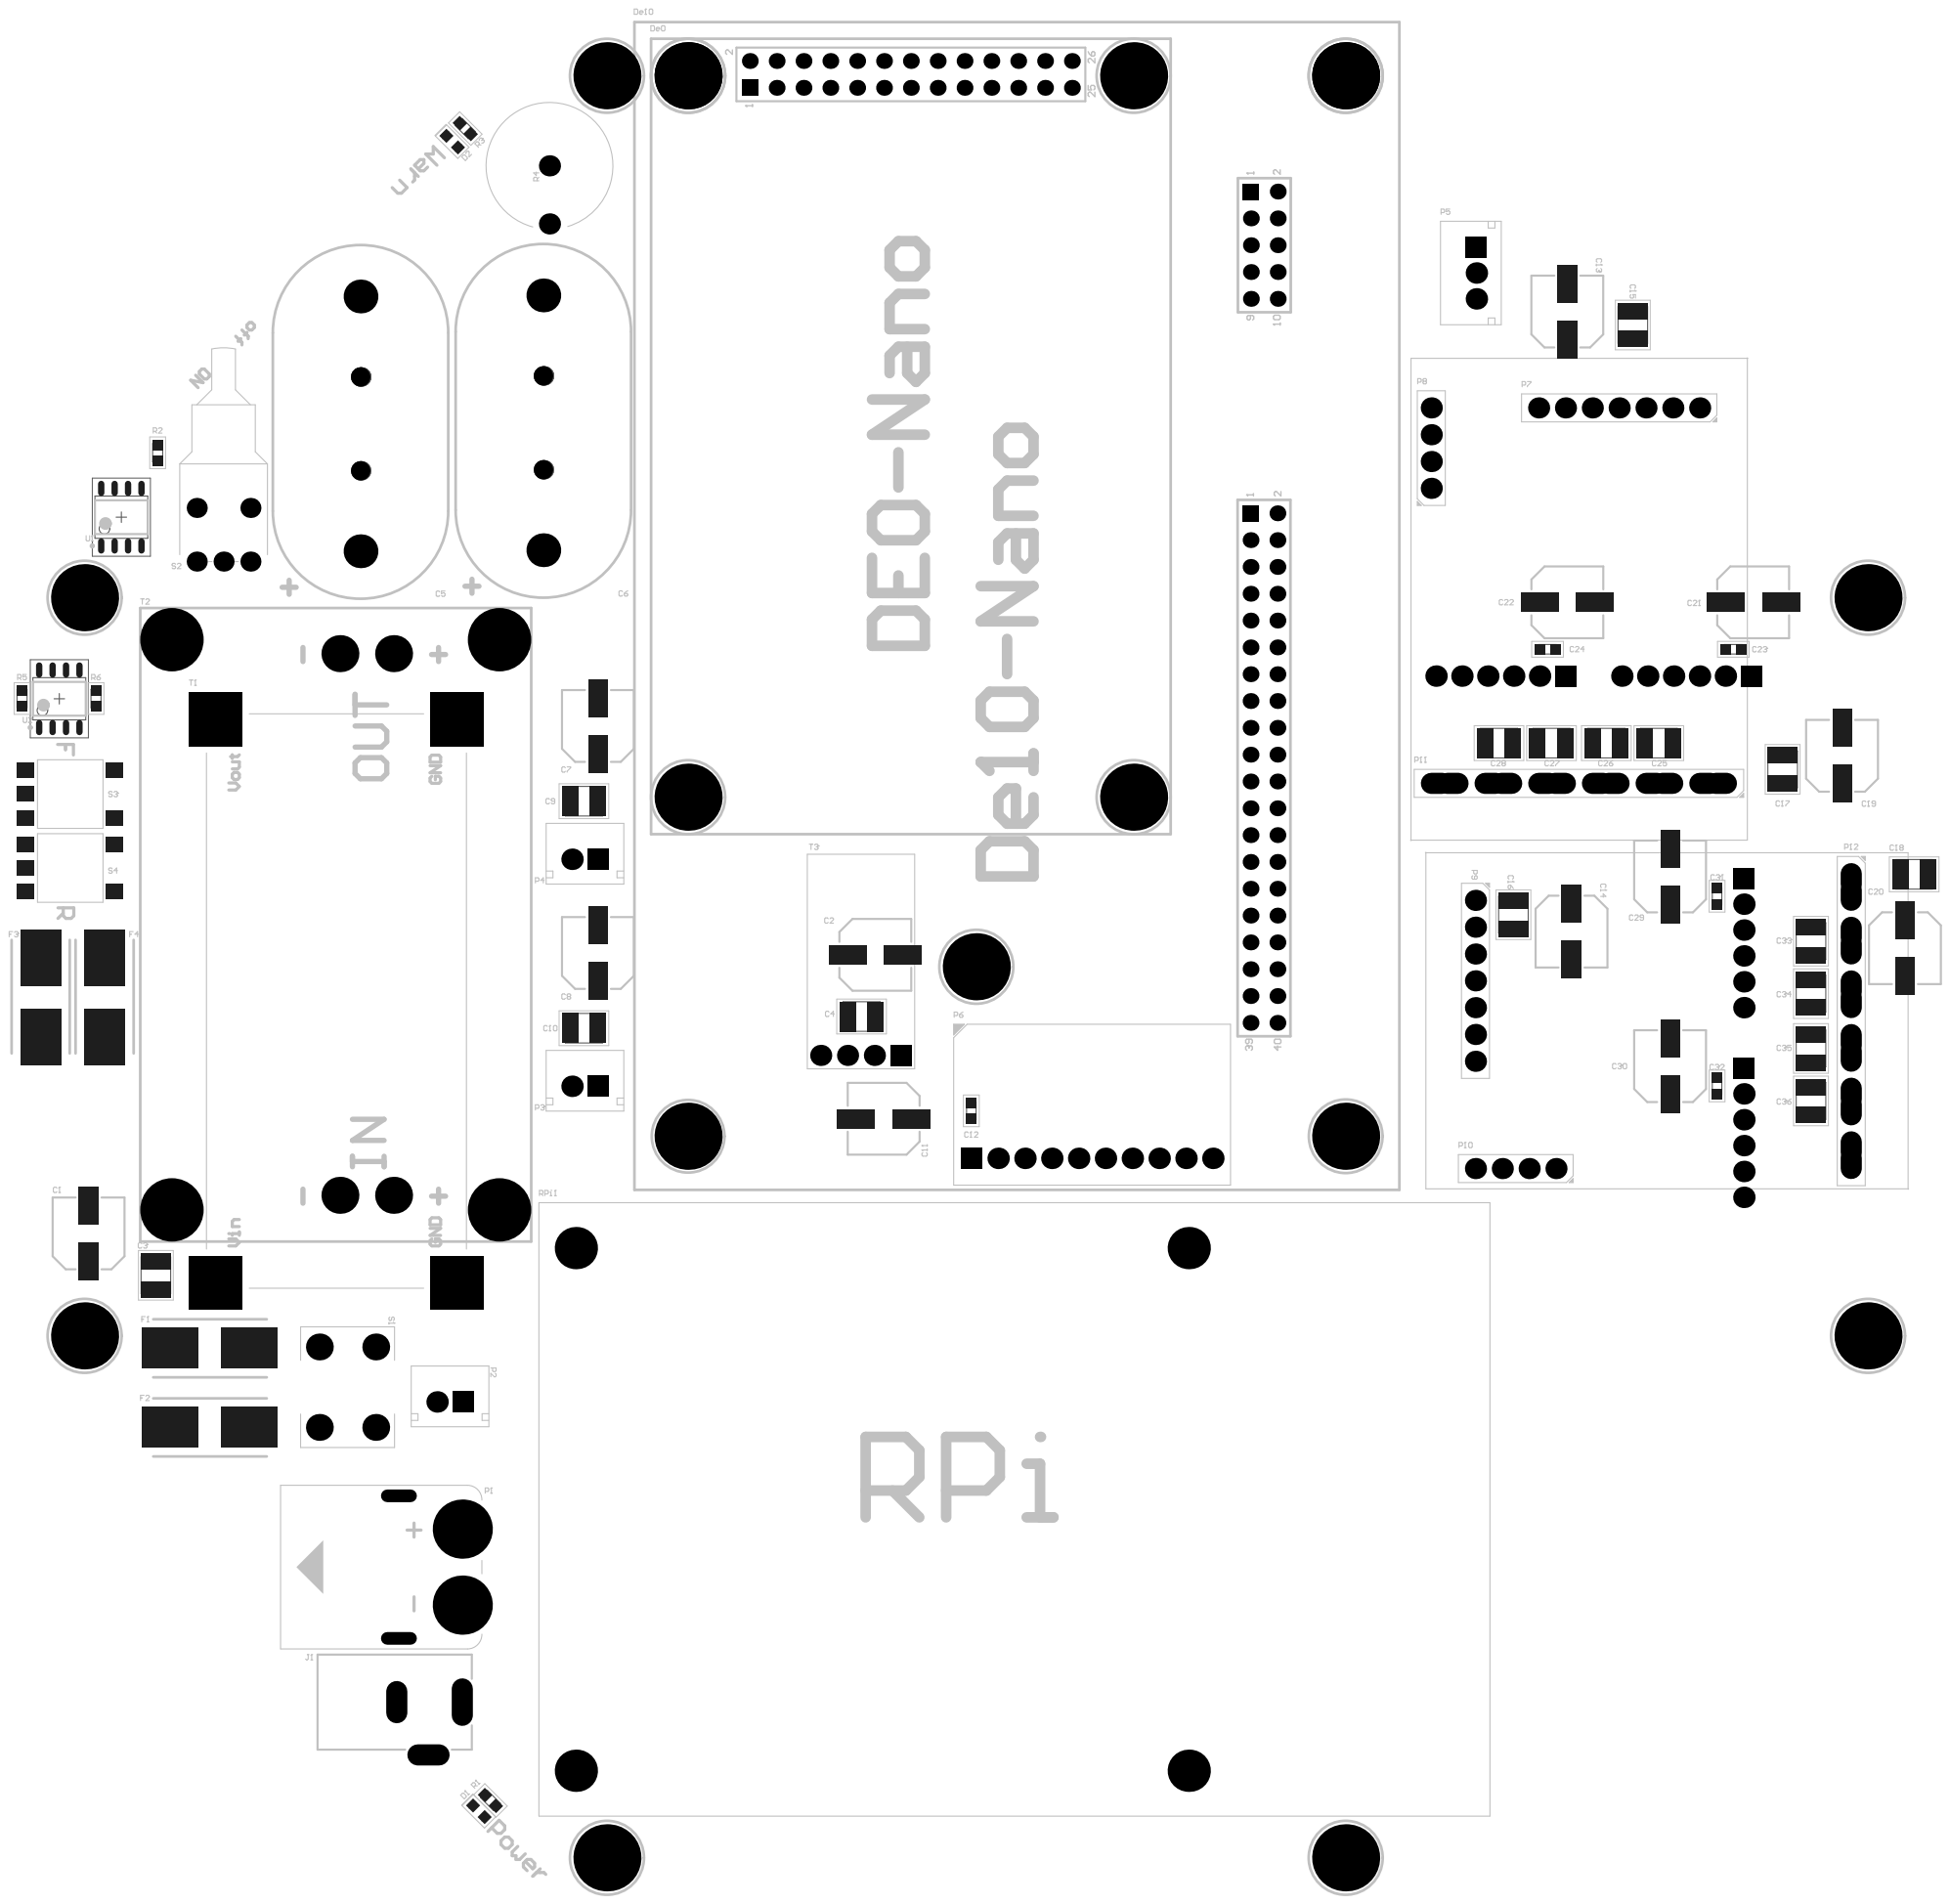
[picture p27: page 1]

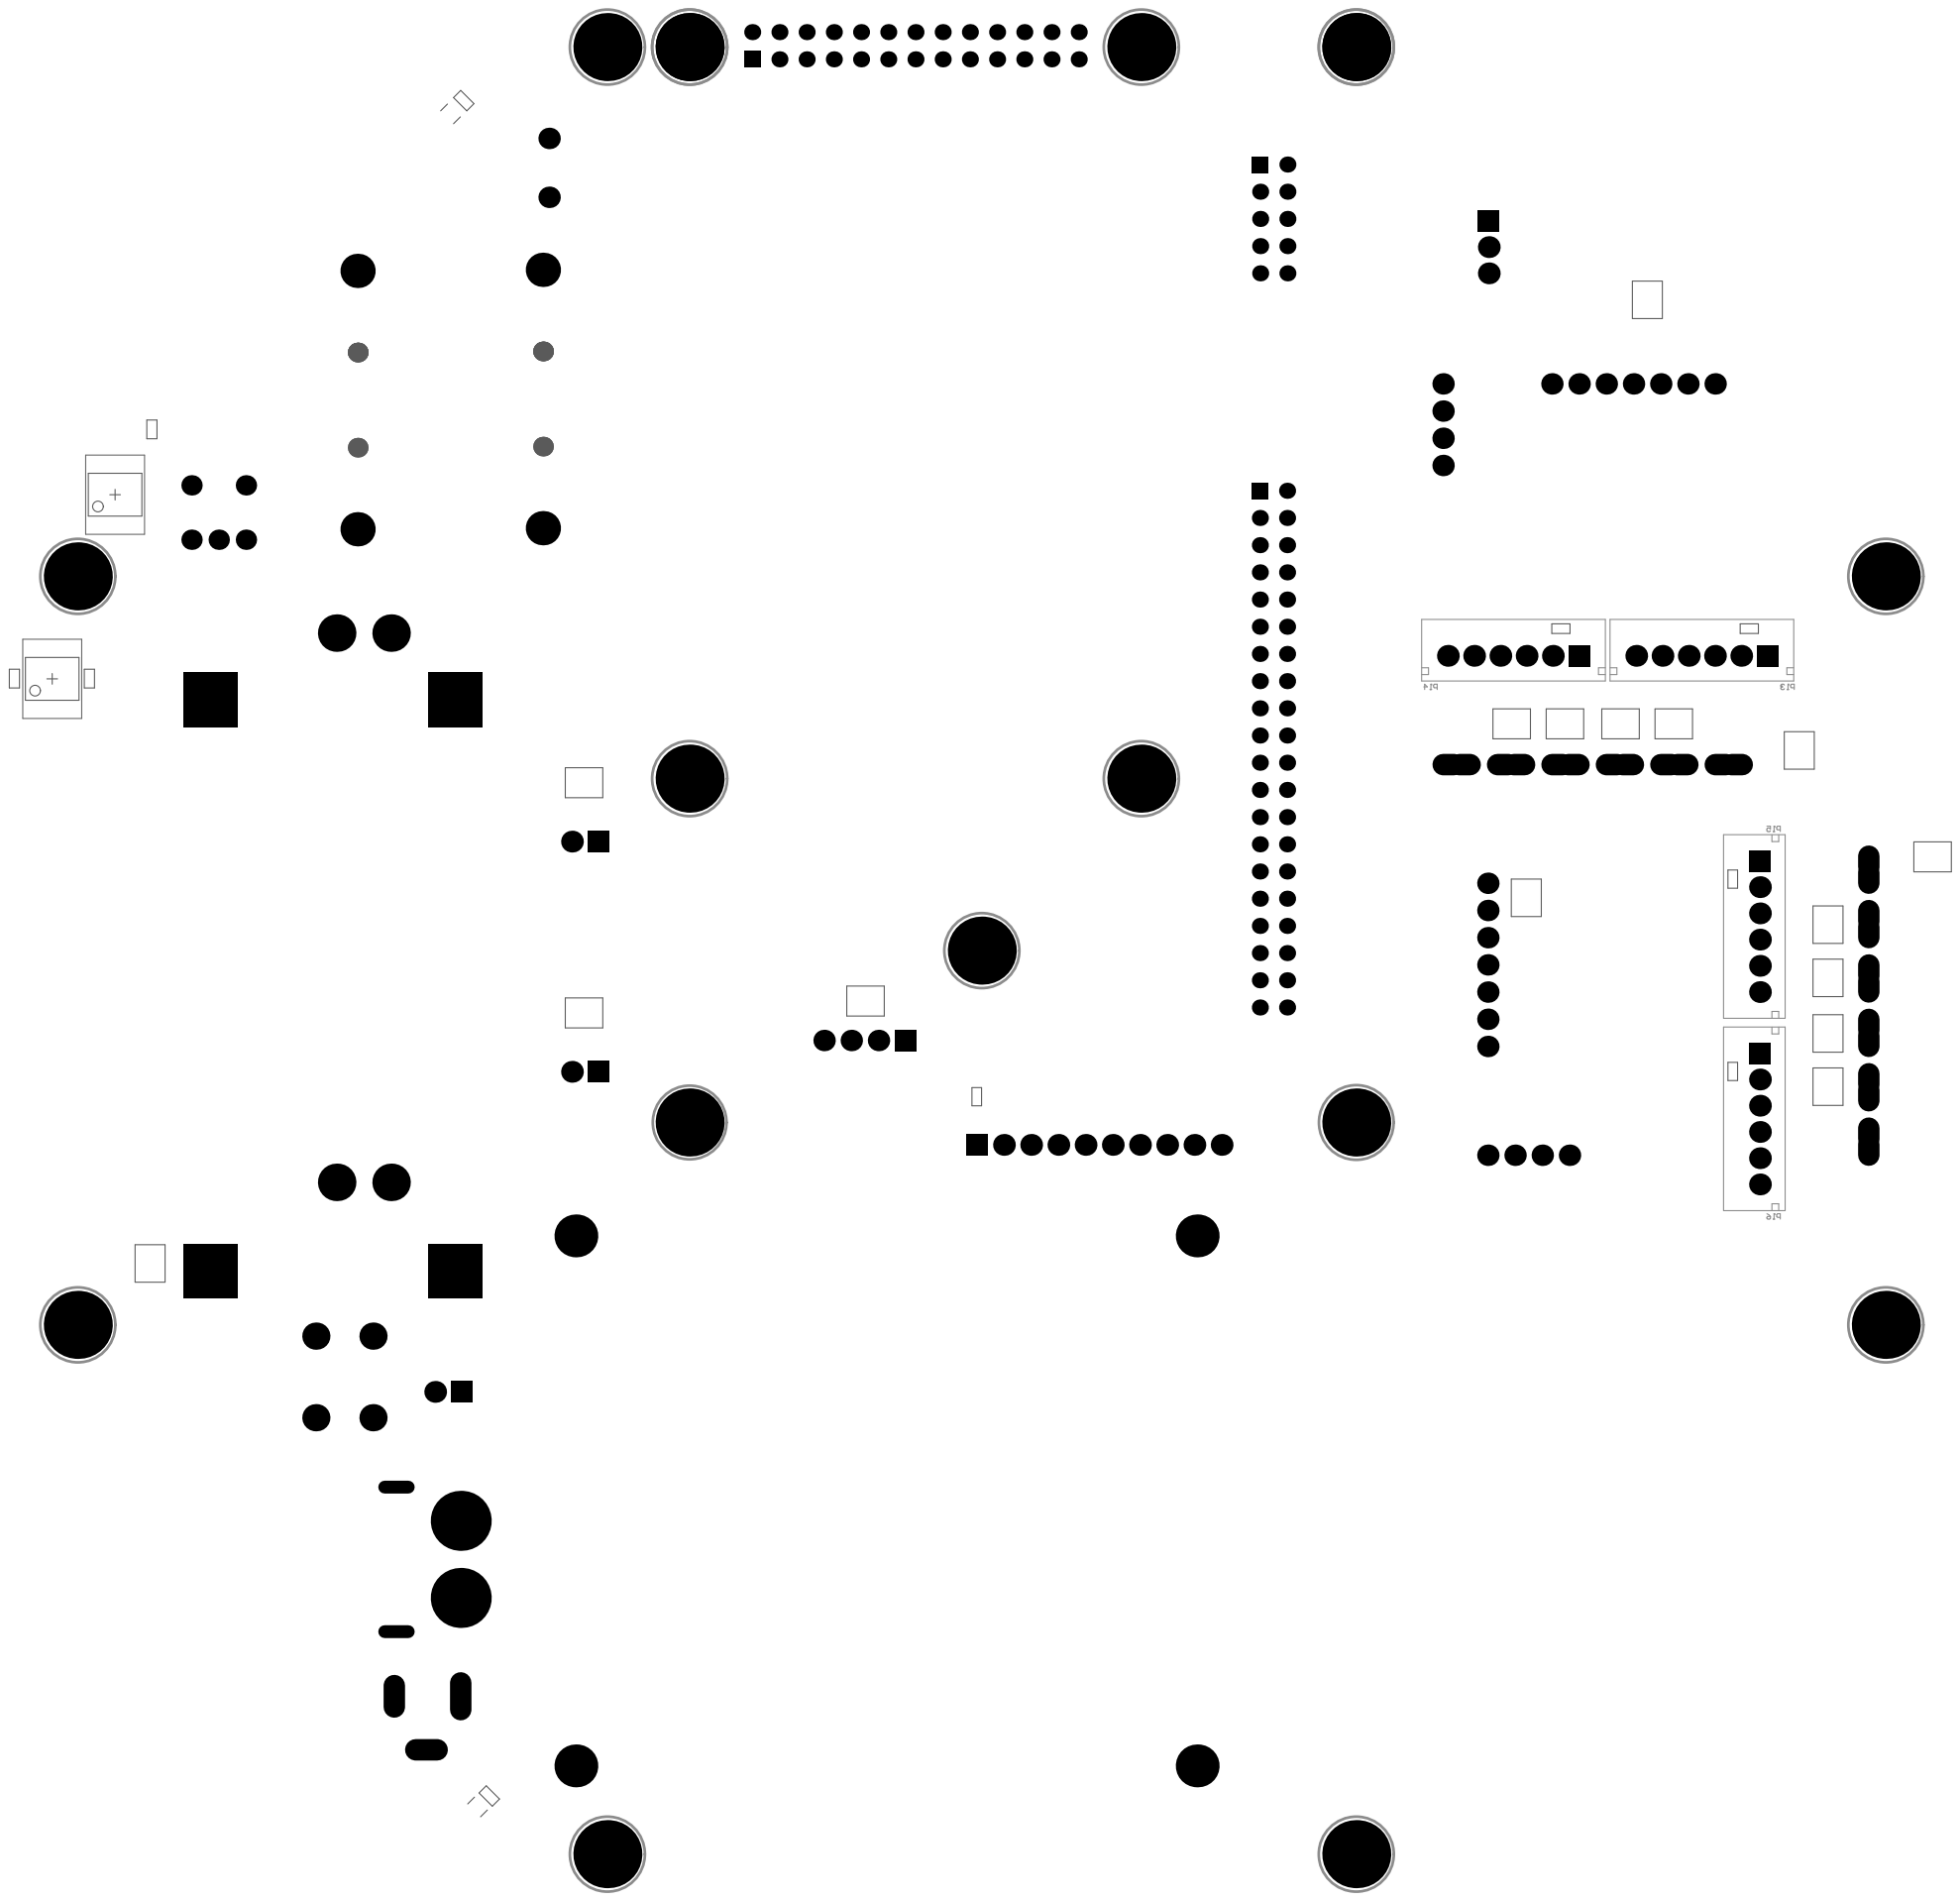
[picture p28: page 2]
