ycpss91255/digital_twin/Output_PCB/Module_maybe_v2/MotorCtrl_v1/Assembly Drawings/Assembly Drawings.PDF

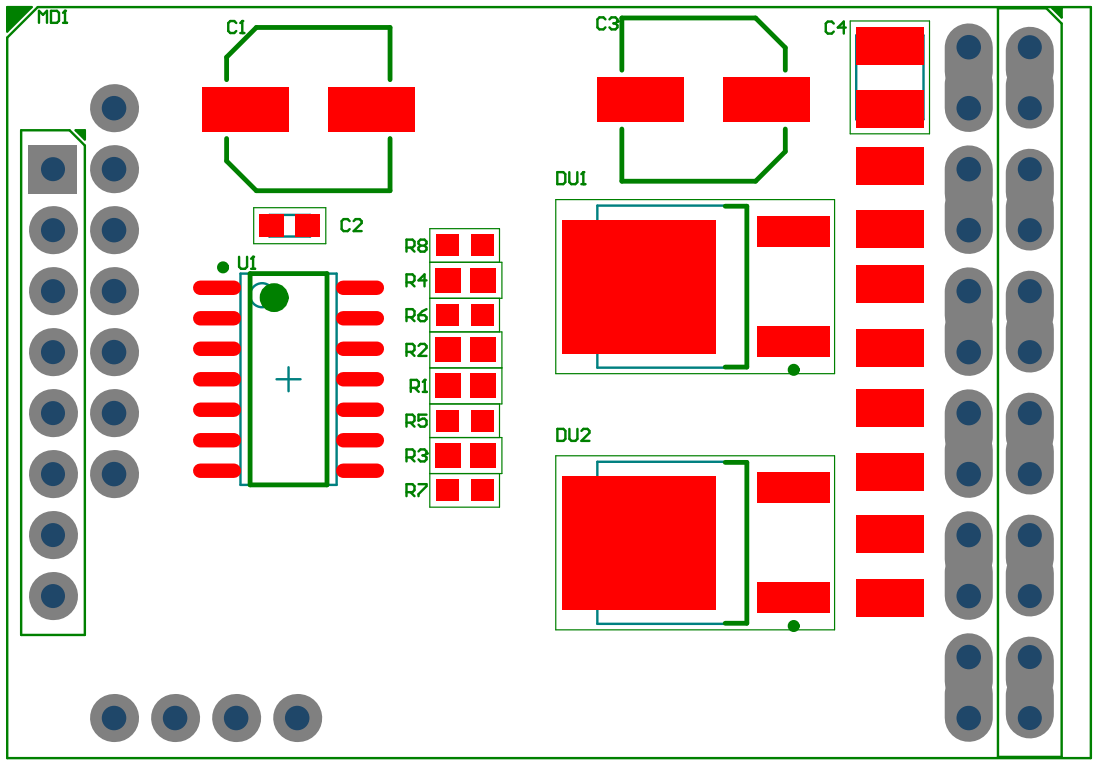
[picture p29: page 1]

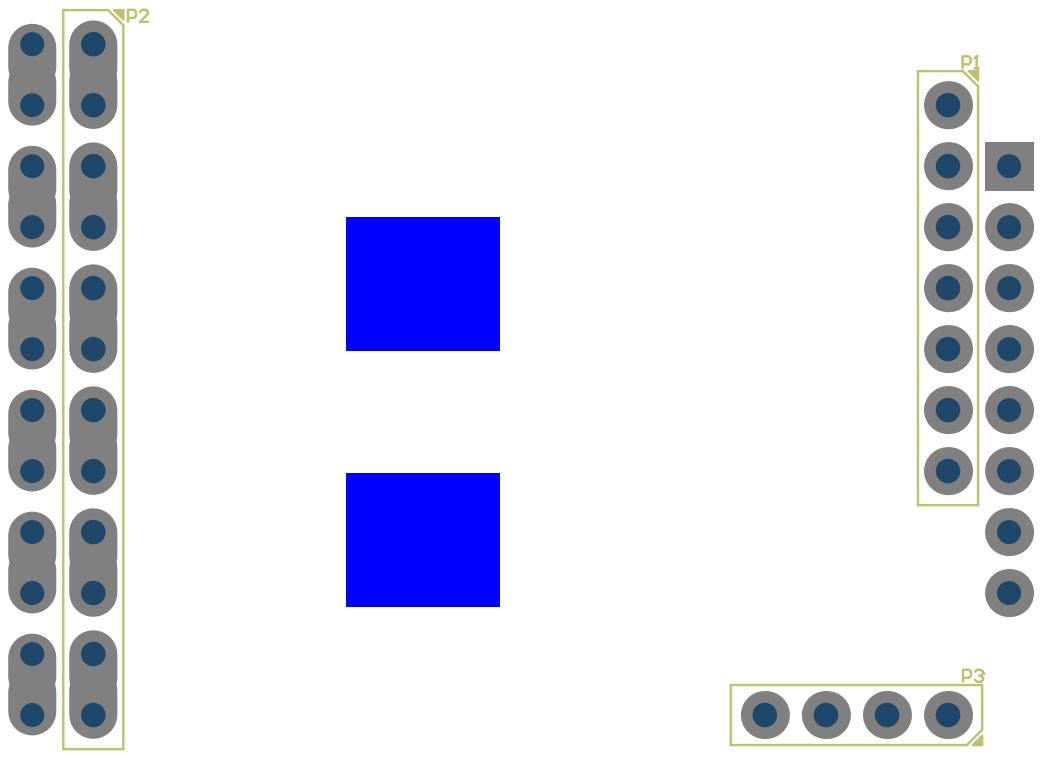
[picture p30: page 2]
