ycpss91255/digital_twin/Output_PCB/Module_maybe_v2/MotorCtrl_v1/Schematic Prints/Schematic Prints.PDF

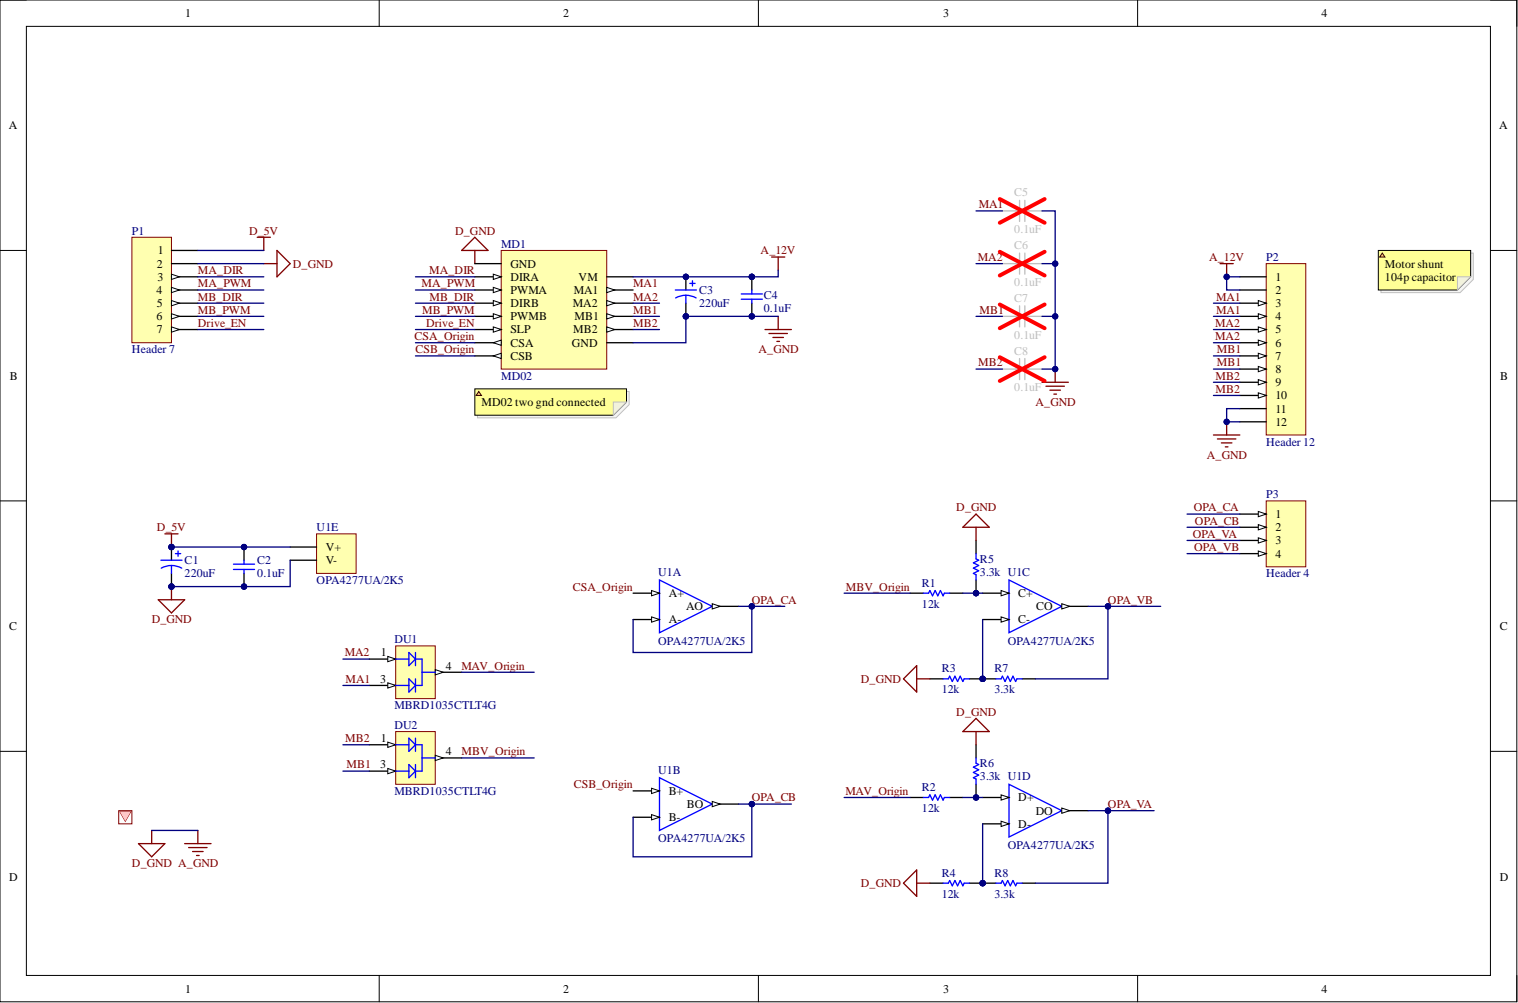
[picture p31: page 1]
