ycpss91255/digital_twin/Output_PCB/integration_v1/PDF File/Schematic Print/Schematic Prints.PDF

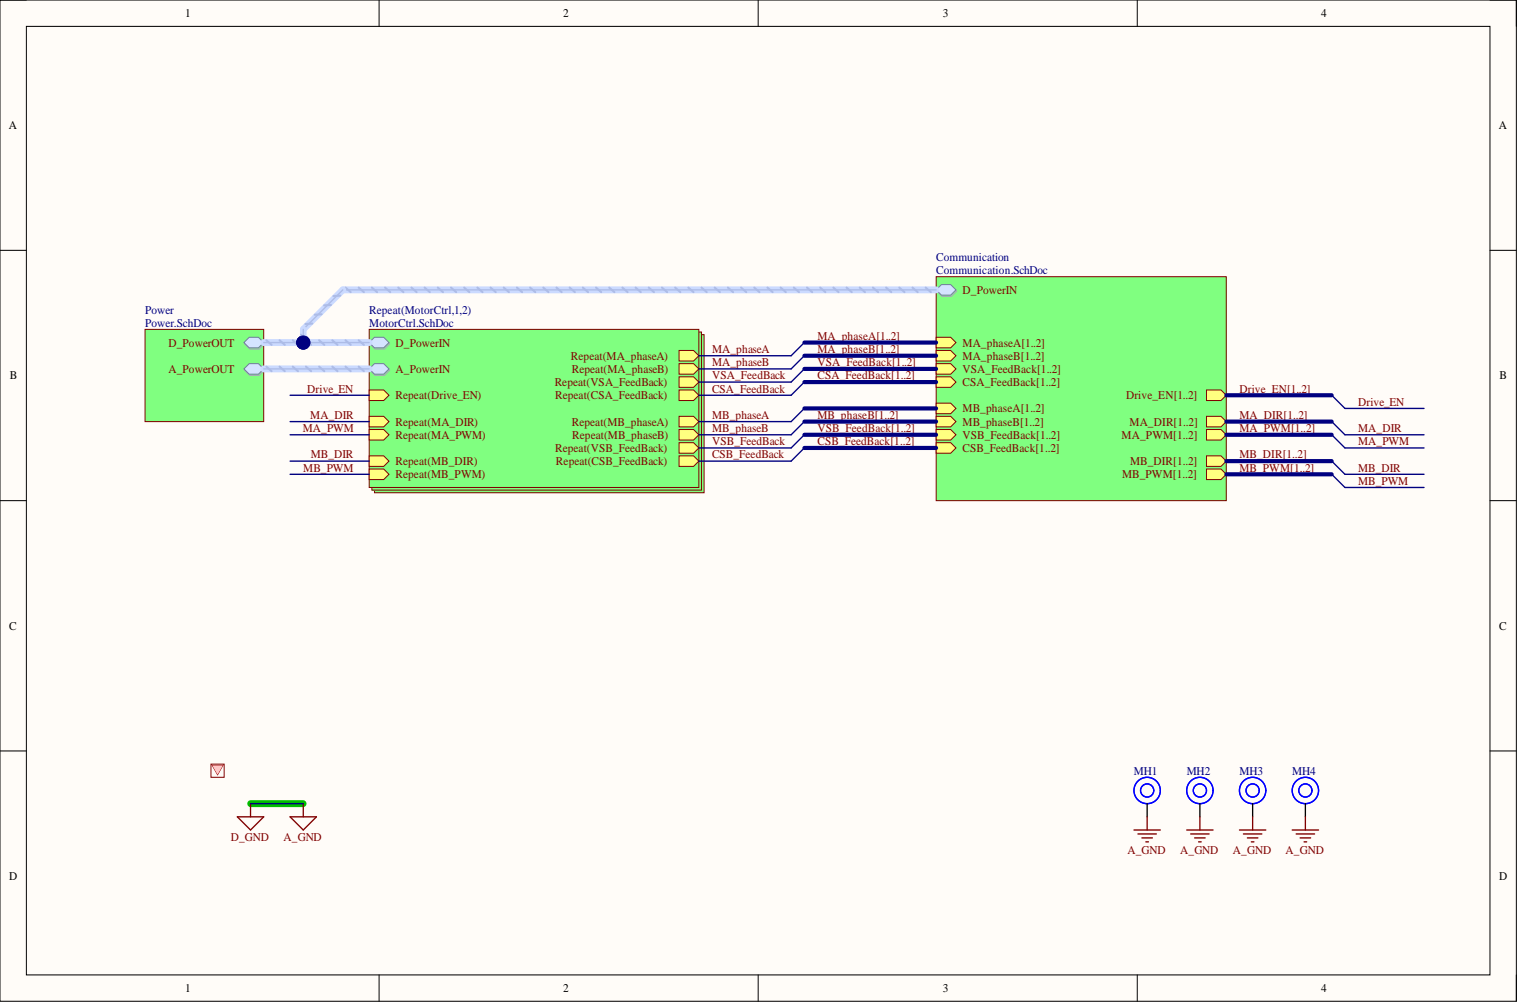
[picture p32: page 1]

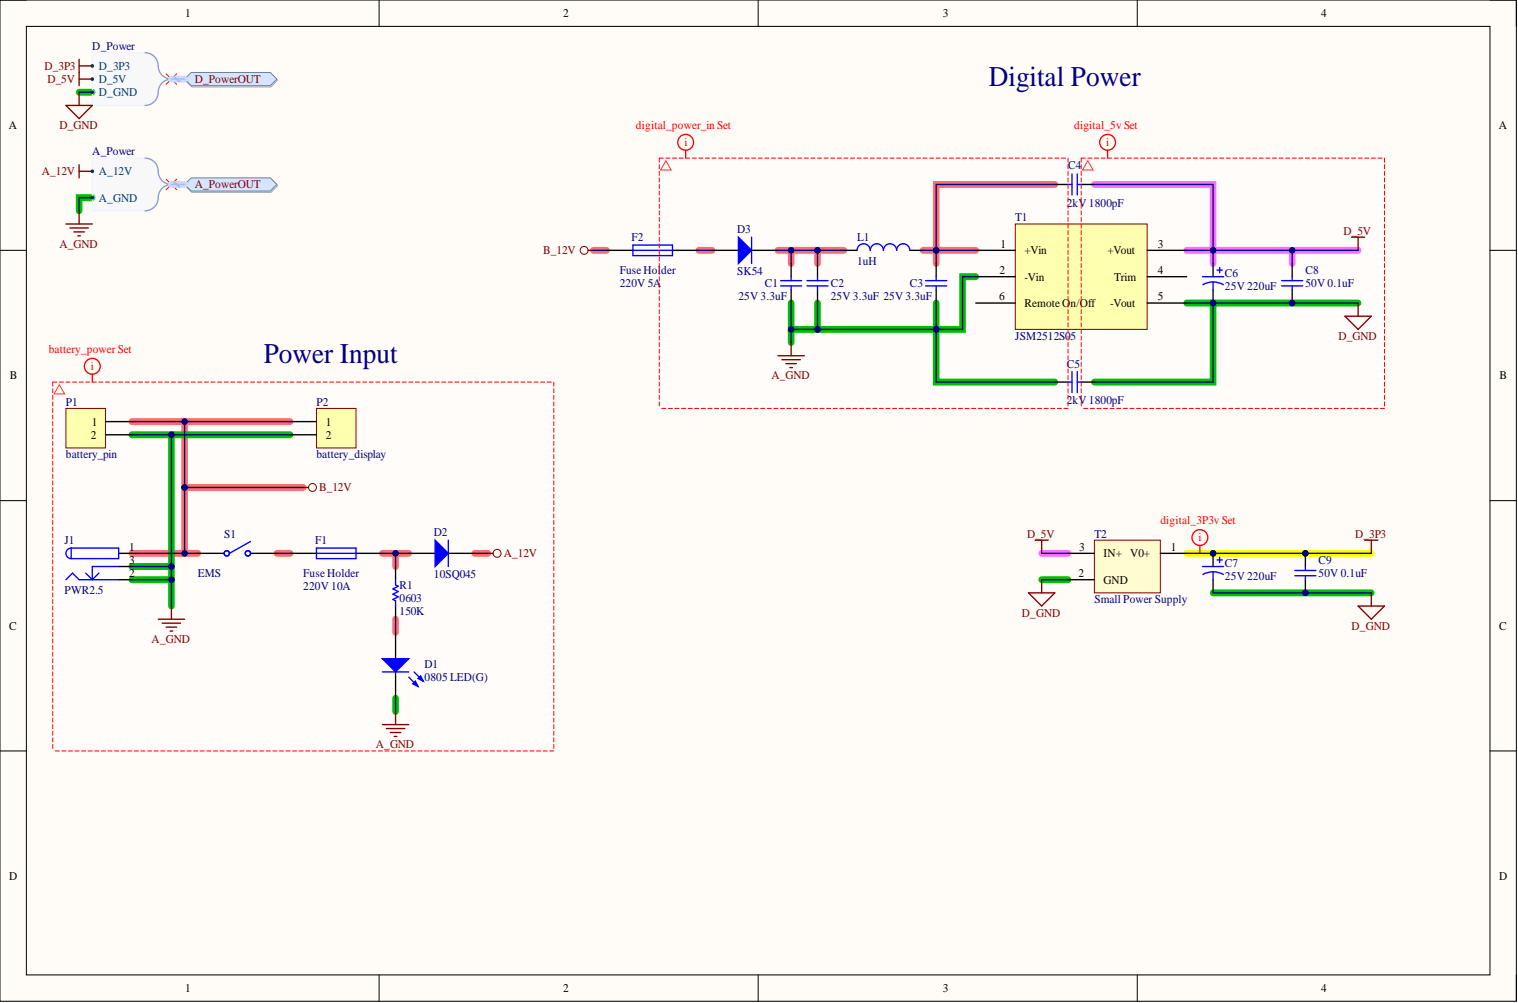
[picture p33: page 2]

+Vin 1 -Vin 2

Remote On/Off 6

JSM2512S05

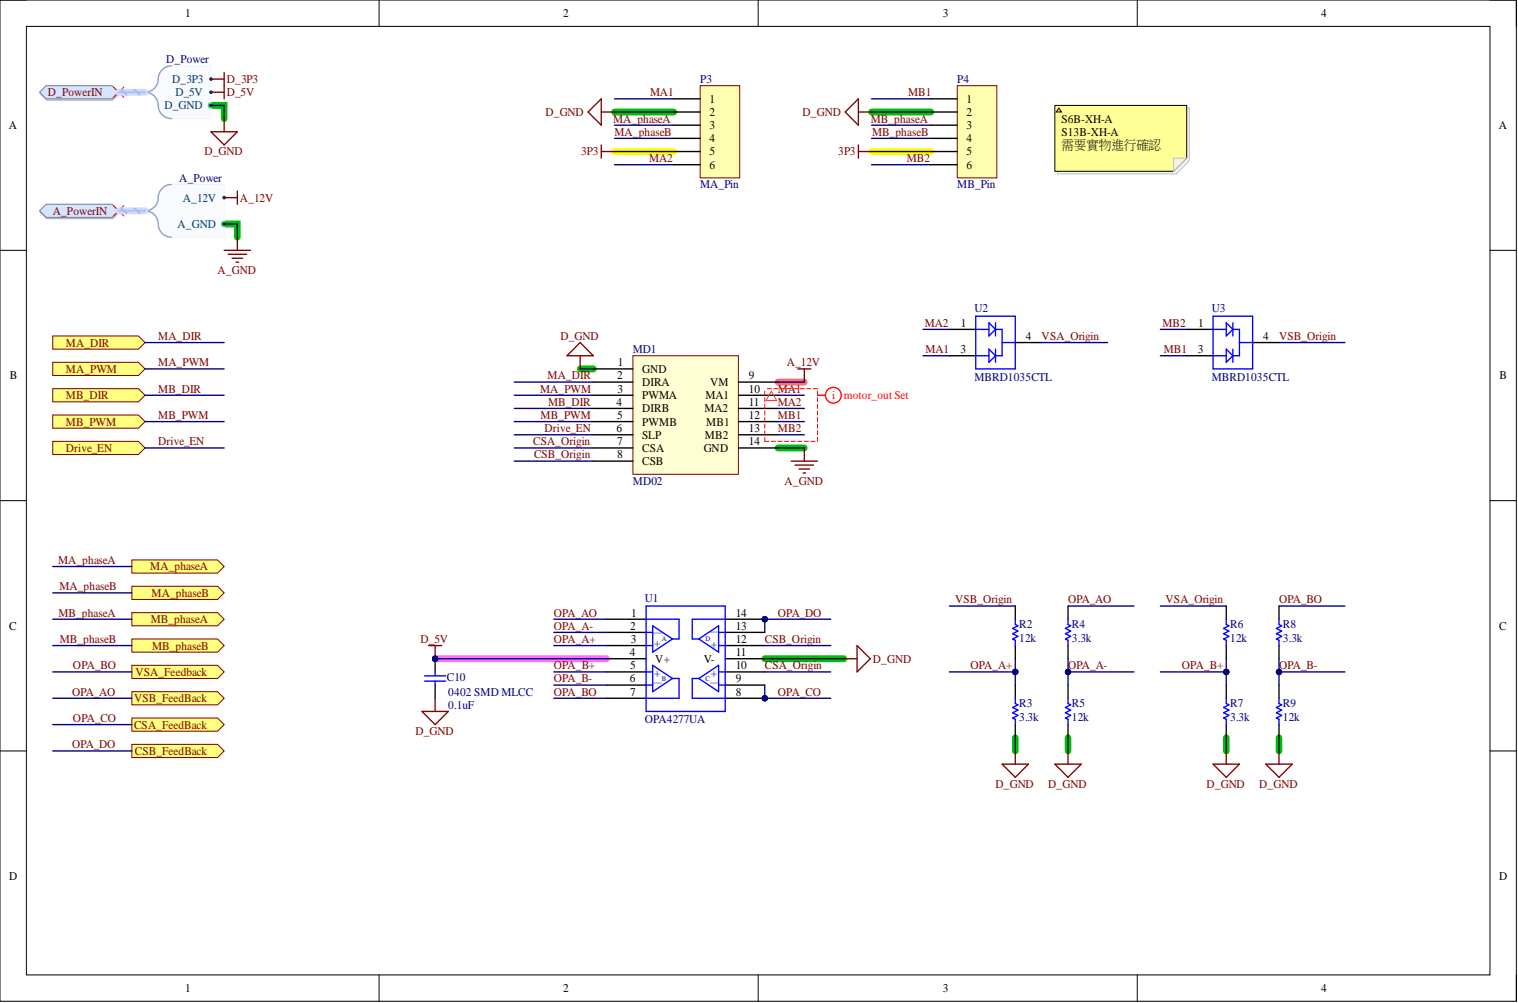
[picture p34: page 3]

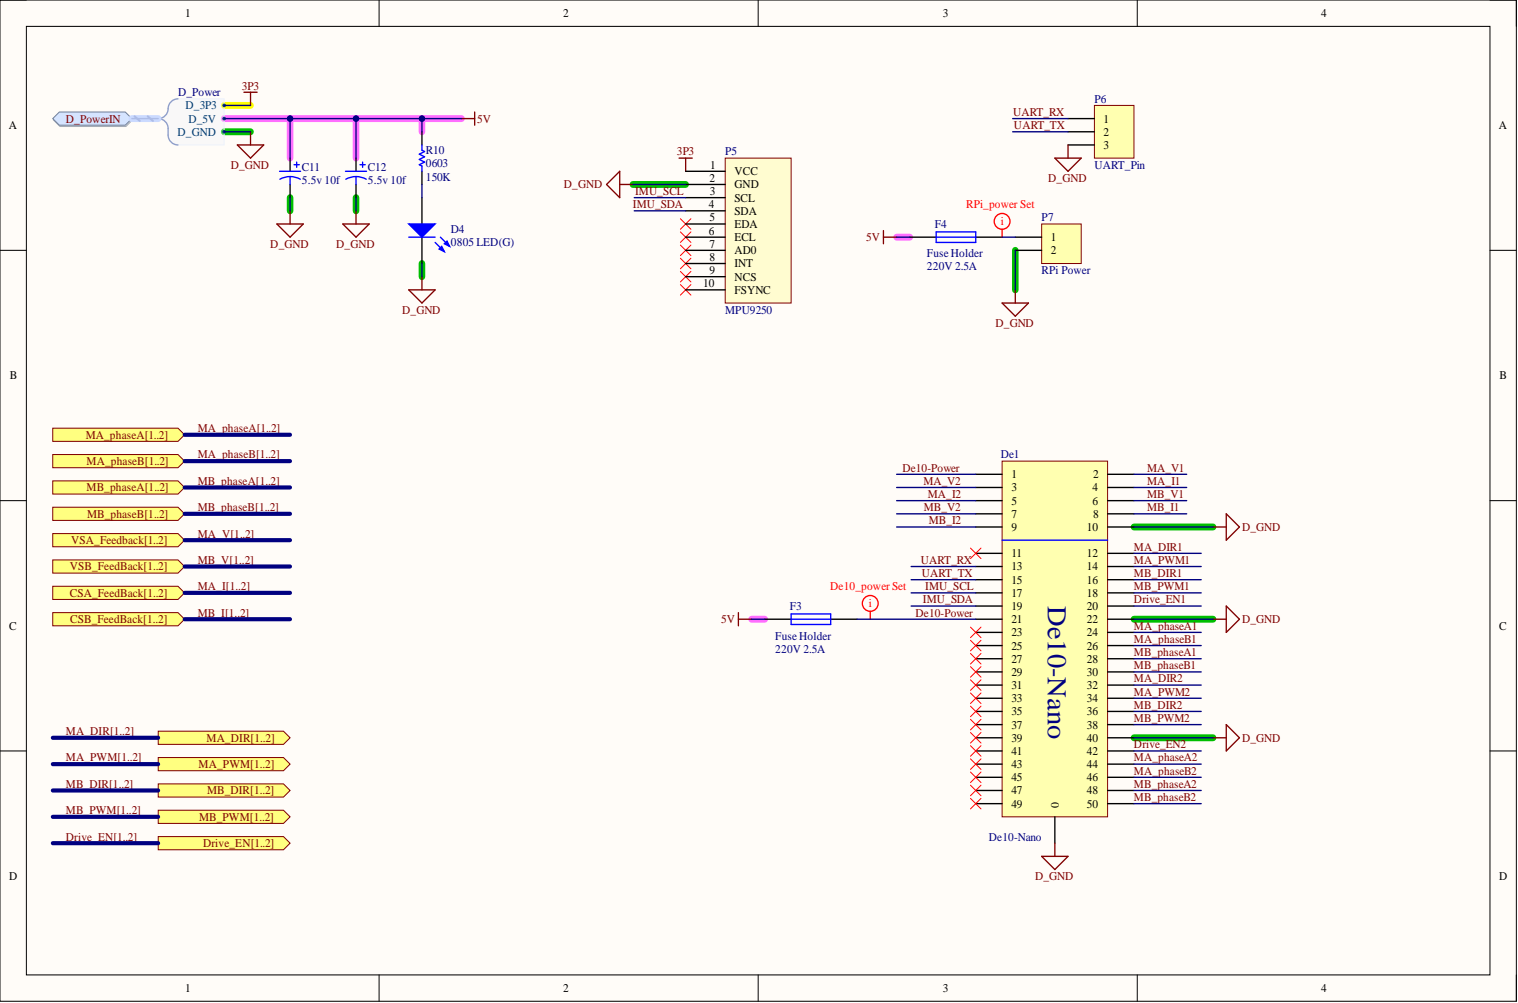
[picture p35: page 4]
