ycpss91255/digital_twin/Power/USB-C Power/Project Outputs for USB-C Power/v1/PDF/Assembly Drawings.PDF

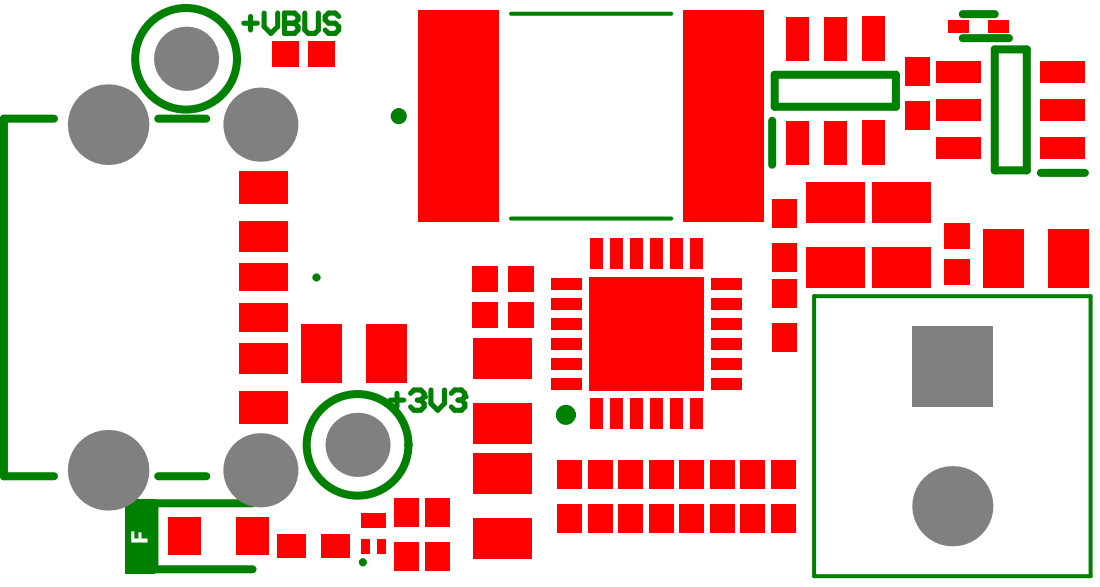
[picture p37: page 1]
