ycpss91255/digital_twin/Power/USB-C Power/Project Outputs for USB-C Power/v1/PDF/Composite Drawing.PDF

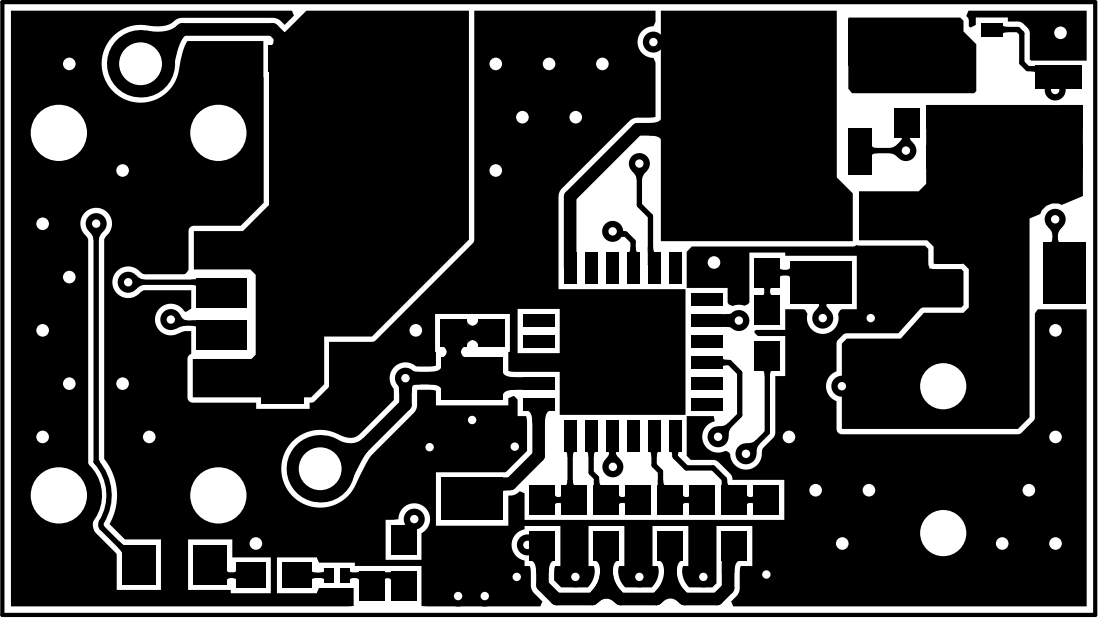
[picture p38: page 1]

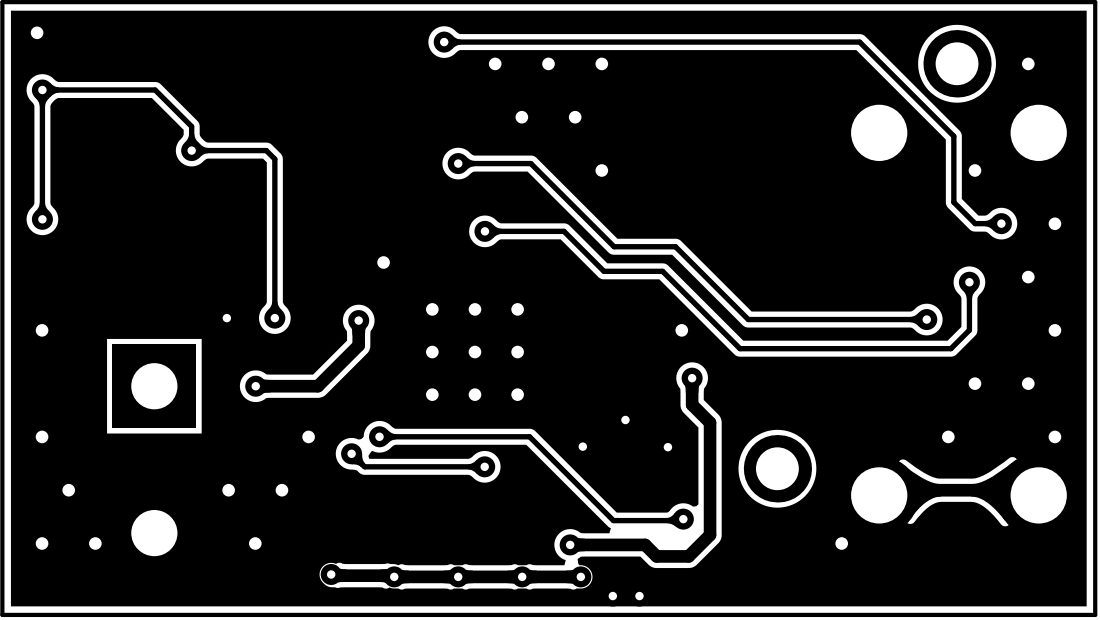
[picture p39: page 2]
