ycpss91255/digital_twin/Output_PCB/integration_v1/PDF File/PCB Print/Assembly Drawings.PDF

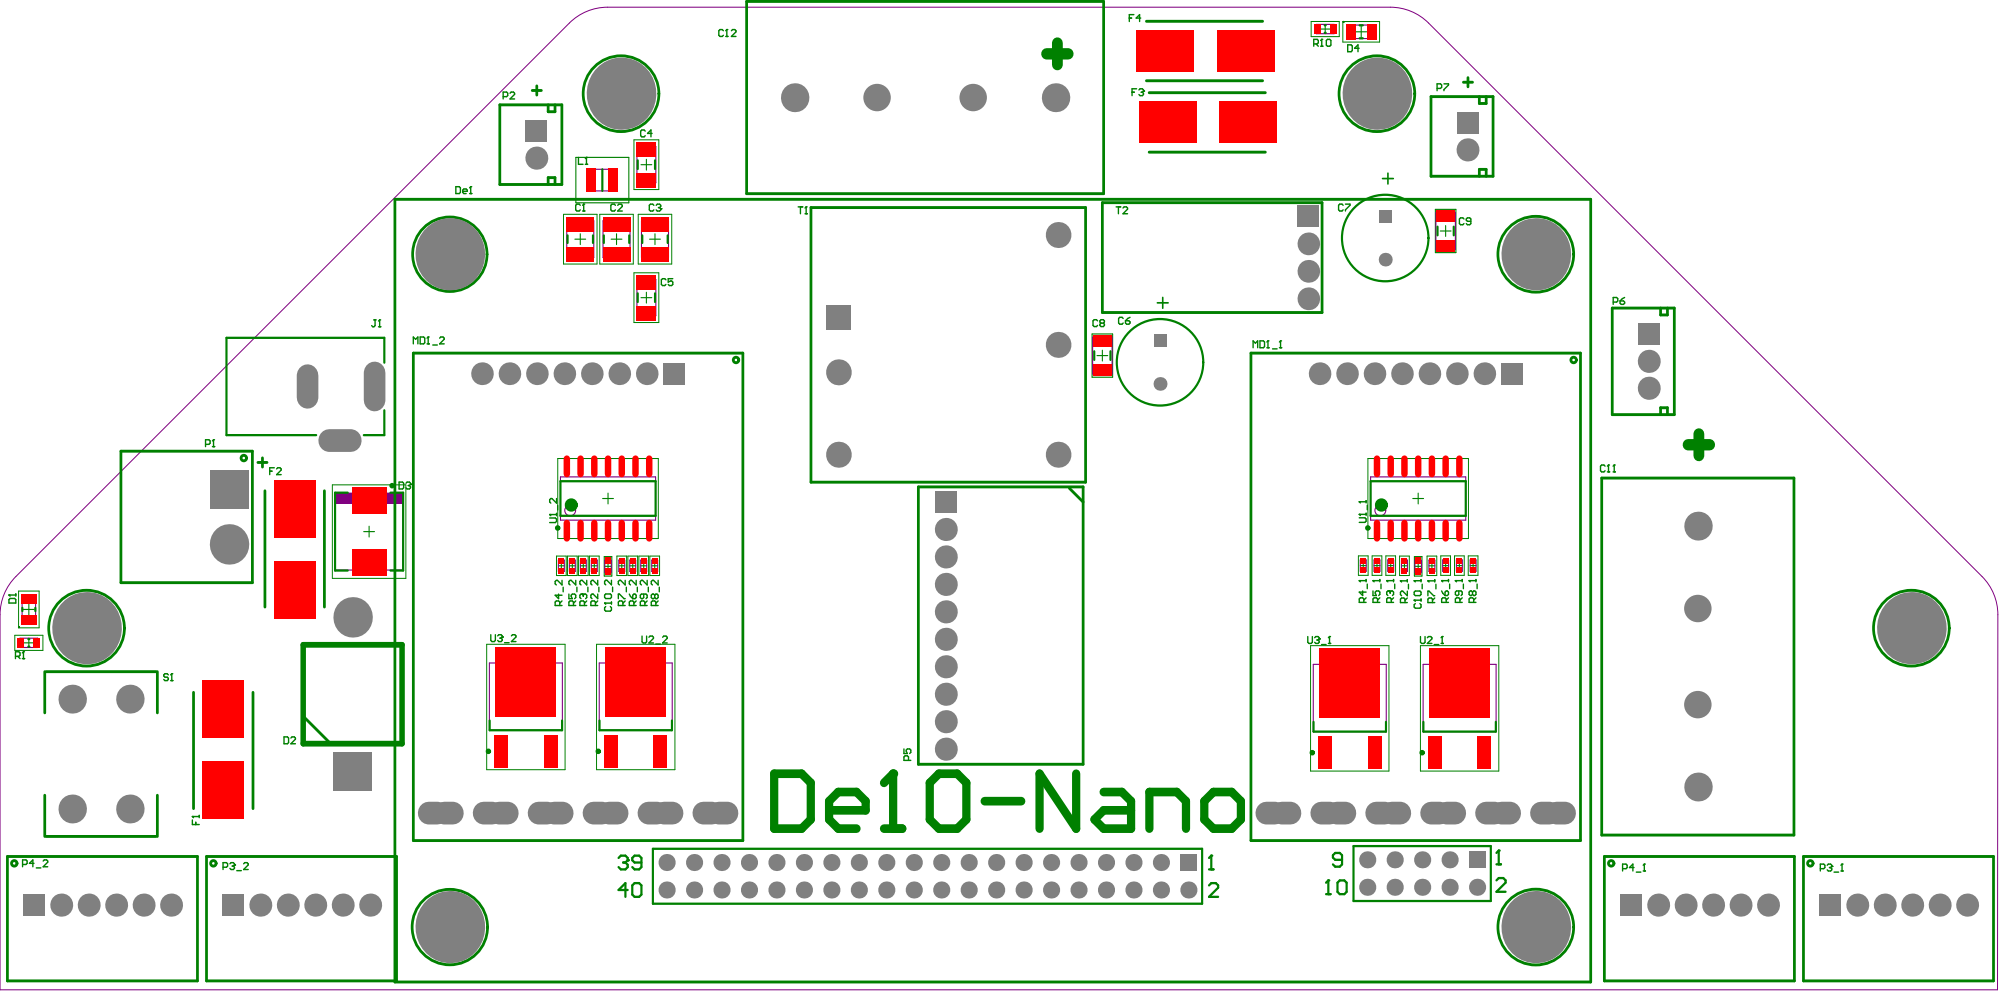
[picture p40: page 1]

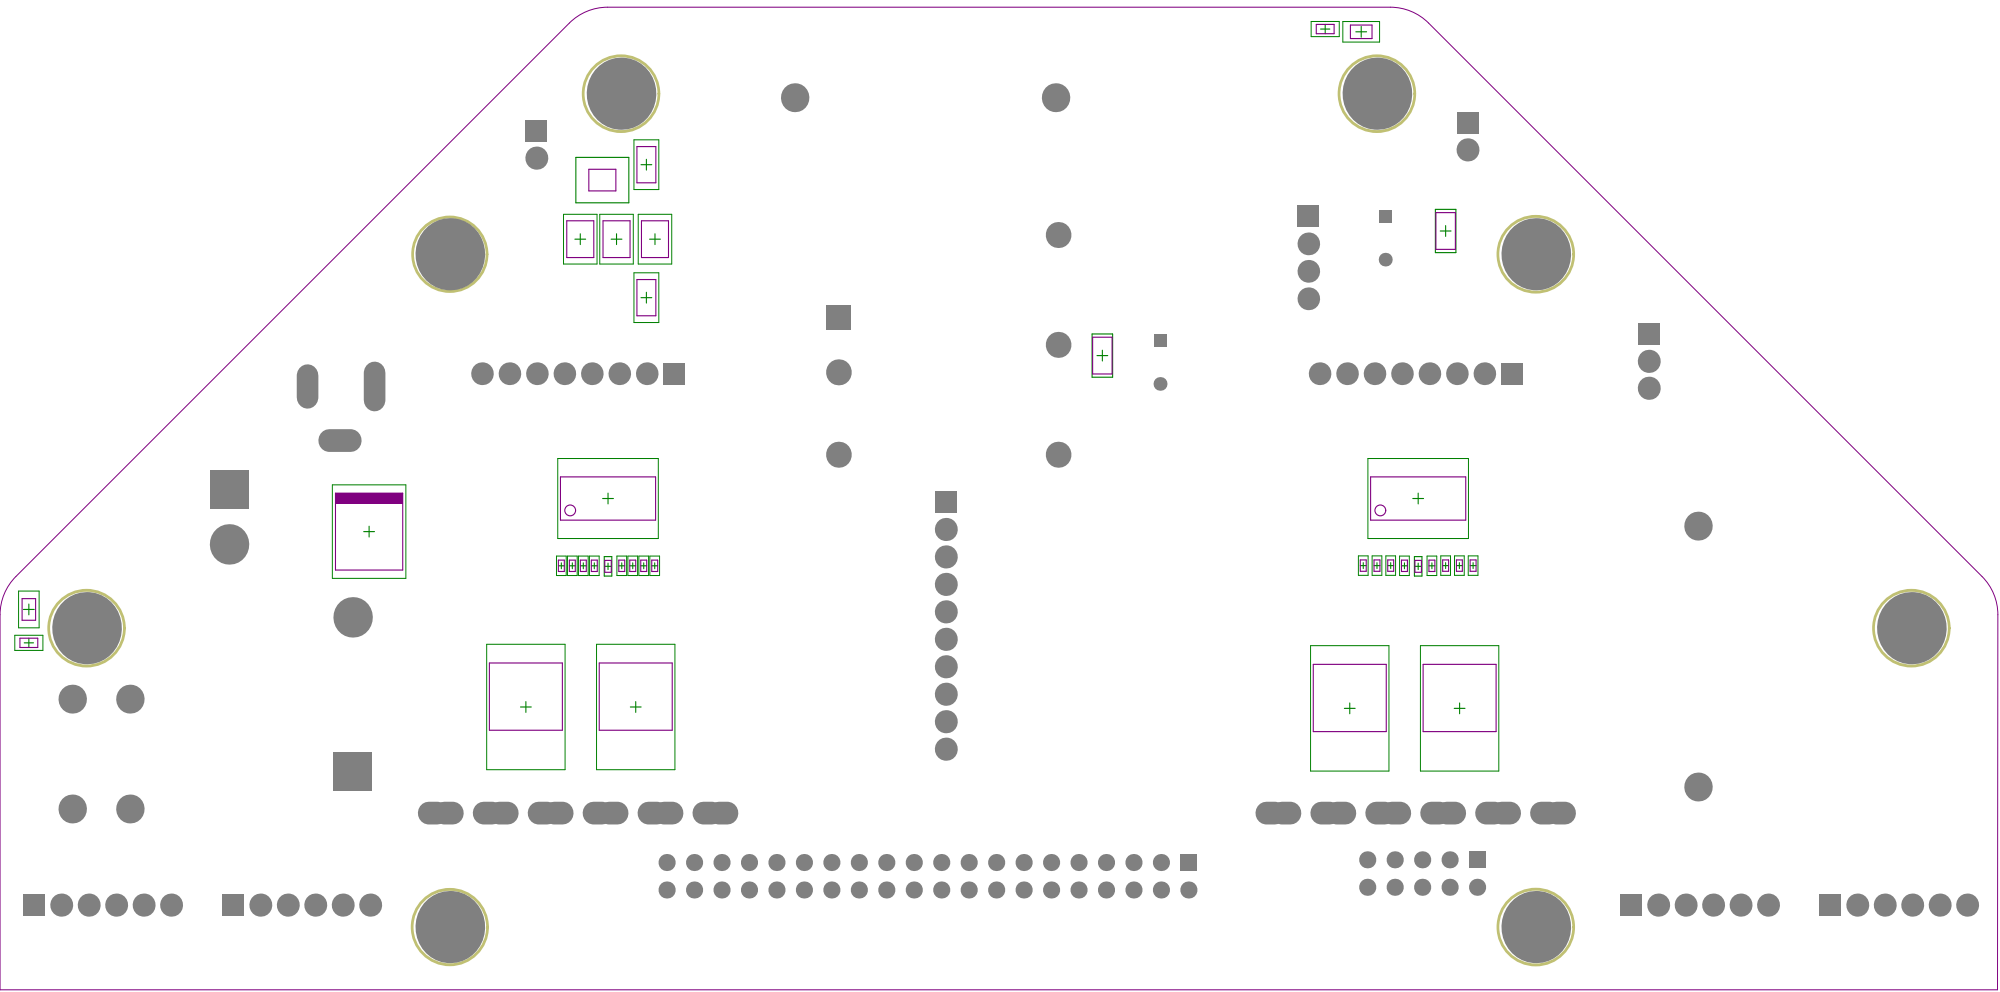
[picture p41: page 2]
