ycpss91255/digital_twin/Output_PCB/integration_v1/PDF File/PCB Print/Composite Drawing.PDF

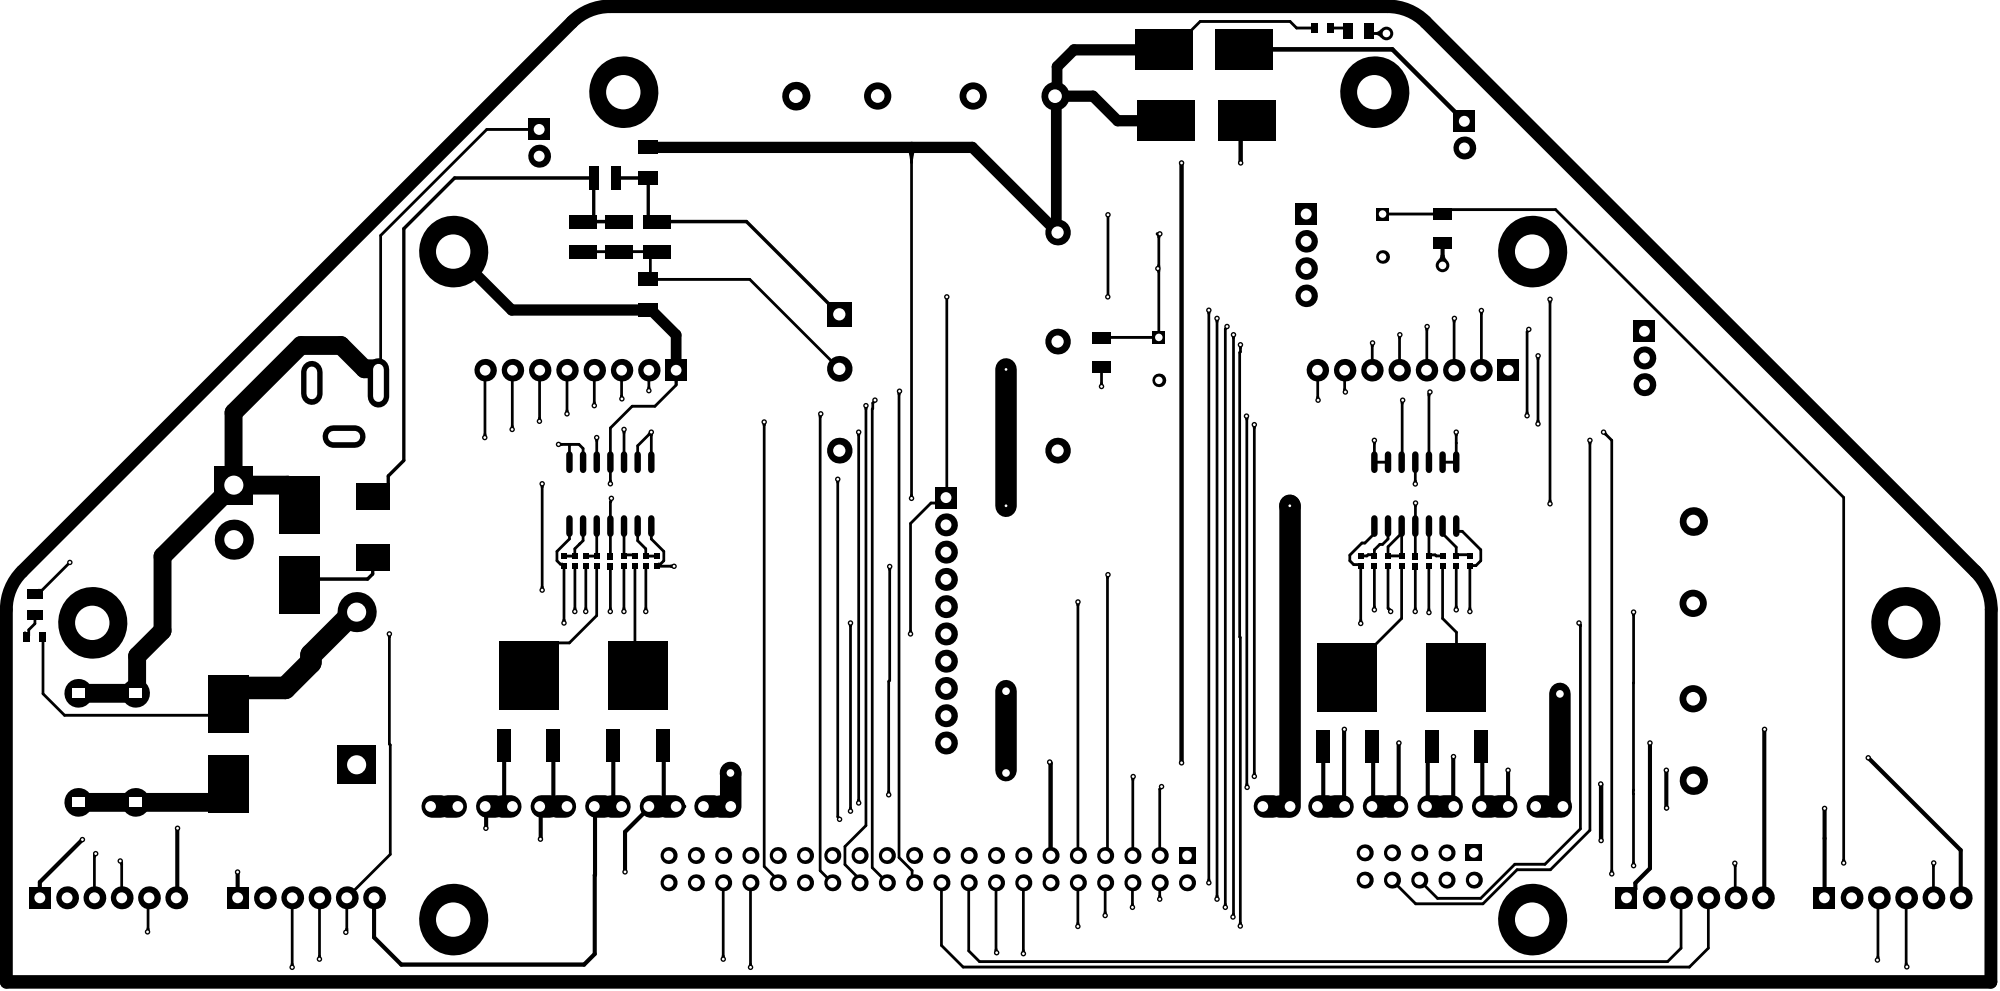
[picture p42: page 1]

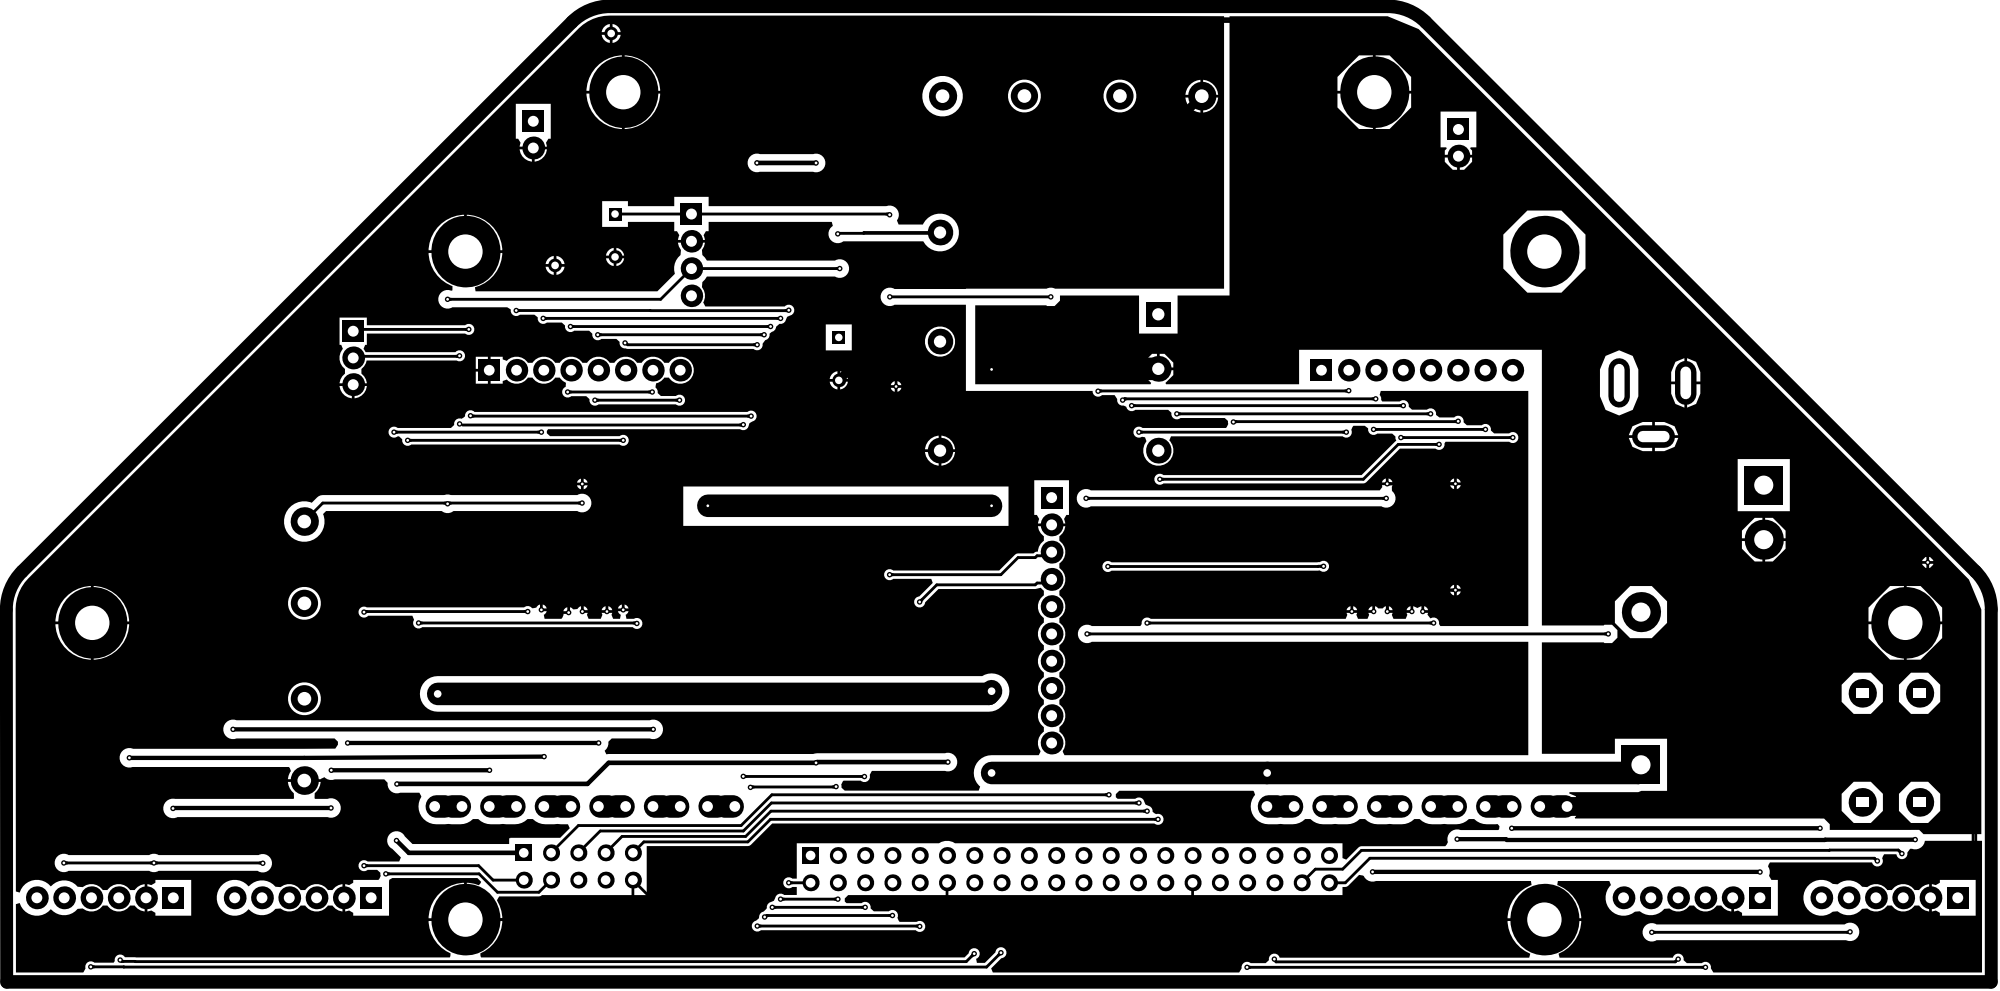
[picture p43: page 2]
