ycpss91255/digital_twin/(list of files, drawings)

Other design files:
Communication/Communication.PcbDoc
Communication/Communication.PrjPcb
Communication/Communication.SchDoc
MotorCtrl/MotorCtrl2.SchDoc
MotorCtrl/MotorCtrl.PcbDoc
MotorCtrl/MotorCtrl.PrjPcb
old_data/digital_twin-Hardware-modular/Main/Block Diagram.SchDoc
old_data/digital_twin-Hardware-modular/Main/Cover Page.SchDoc
old_data/digital_twin-Hardware-modular/Main/IO and Comm.SchDoc
old_data/digital_twin-Hardware-modular/Main/Main.PcbDoc
old_data/digital_twin-Hardware-modular/Main/Main.PrjPcb
old_data/digital_twin-Hardware-modular/Main/Motor Drive Board Header.SchDoc
old_data/digital_twin-Hardware-modular/Main/Power.SchDoc
old_data/digital_twin-Hardware-modular/MotorCtrl/MotorCtrl.PcbDoc
old_data/digital_twin-Hardware-modular/MotorCtrl/MotorCtrl.PrjPcb
old_data/digital_twin-Hardware-modular/MotorCtrl/MotorCtrl.SchDoc
old_data/OWMR.PcbLib
old_data/OWMR.SchLib
OWMR/OWMR.PrjPcb
OWMR/Top.PcbDoc
Power/Power.PcbLib
Power/Power.SchLib
Power/USB-C Power/Battery_and_Bypass_Controller_Connectons.SchDoc
Power/USB-C Power/Battery_Charging_and_Bypass_Power_Supply.SchDoc
Power/USB-C Power/Block_Diagram.SchDoc
Power/USB-C Power/Cover_Page.SchDoc
Power/USB-C Power/MCU_and_Peripheral_Circuits.SchDoc
Power/USB-C Power/PD_BCR_Connections.SchDoc
Power/USB-C Power/PD_Controll_and_LEDs.SchDoc
Power/USB-C Power/Revision_History.SchDoc
Power/USB-C Power/Top_Level.SchDoc
Power/USB-C Power/Type-C_Connector_and_PD_Switch.SchDoc
Power/USB-C Power/USB-C Power.PcbDoc
Power/USB-C Power/USB-C Power.PrjPcb
Power/USB-C Power/Voltage_Regulator_and_Load_Connectors.SchDoc
Simulation/Simulation.PrjPcb
Simulation/Simulation.SchDoc
