ycpss91255/digital_twin/(commit log)

2021-02-26 add : rplidar lib add : rplidar rules adjust : dockerfile 20210226001
    [materials.xacro, omwr.xacro, omwr_link.STL, wheel_link_1.STL, wheel_link_2.STL, wheel_link_3.STL, wheel_link_4.STL]
2021-03-16 tmp : switch env
2021-03-19 add : new omwr model add : dockerfile zsh support
    [omwr.xacro, omwr_link.STL, wheel_link_1.STL, wheel_link_2.STL, wheel_link_3.STL, wheel_link_4.STL]
2021-03-20 add : Forwar and Inverse kinematics add new kinematics header and test file and link c header file
2021-03-20 adjust : dockerfile add : powerlevel10k zsh
2021-03-31 add : motor enc msg adjust vscode workspace path
    20200331001
2021-03-31 debug : sim robot controller 1
    [omwr.xacro]
2021-04-05 del : motor_data.h adjust motion .h .cpp structure 20200405001
2021-04-05 fix : simulator node_handle MotorSpeedBack publish issue 20210405004
2021-04-19 adjust : ros ip
2021-04-21 add : motor_control.cpp .h adjust : model posture
2021-04-21 fix : gazebo read time factor Don't set up weird physical models!!!
    [omwr.xacro]
2021-04-22 add : wheel spin a circle
2021-04-25 add : real and digital motor sync control
2021-04-27 add : arduino real voltage .ino
2021-04-30 add : arduino test.ino
2021-04-30 add : verilog example
    [DE0_Nano.smp_dump.txt]
2021-05-01 del : fpga code
    [DE0_Nano.smp_dump.txt]
2021-05-01 add : install rosserial and rosserial-arduino
2021-05-03 add : get motor command Voltage
2021-05-03 adjust : arduino pub topic 489hz
2021-05-19 add : print n value
2021-05-20 del : extra stuff
    [DE0_Nano.smp_dump.txt]
2021-05-20 add : uart_drive rule adjust : workspace env
2021-05-24 del : printf when debugging
2021-05-24 tmp : switch to rpi4 env
2021-05-27 adjust : printf info and del extra stuff
2021-06-06 adjust : Imu.msg => IMU.msg debug : first catkin_make msg not found
2021-06-19 done : Serial interrupt , wait test
2021-07-14 add : temp sim robot cmd
    [omwr.xacro]
2021-08-30 add : powerlevel10k zsh theme
2021-08-30 fix : wheel reverse movement
2021-08-31 add : get motor data script
2021-08-31 add : wheeled robot kinematics 45-degree version
2021-09-01 add : Enable/Disable motor PID function
2021-09-01 add : test PID mode
2021-11-09 adjust : serial device change to nano_uart
2021-11-13 add : git attributes change file CRLF to LF
    [omwr.xacro, wheel_link_1.STL, wheel_link_2.STL, wheel_link_3.STL, wheel_link_4.STL]
2021-11-13 add : socket class
2021-11-16 fix : socket_class cannot be instantiated
2021-11-19 done : ASR socket server
2021-11-20 adjust : socket server ip
2022-09-26 fix: owmr.stl model not display issue
2022-09-27 add: DE0_Nano code
    [DE系列腳位圖_20210825.xlsx, De0 nano 腳位.xlsx, TimerCounter.stp, TimerCounter_auto_stripped.stp, gsensor.stp, gsensor_auto_stripped.stp, stp1.stp, stp1_auto_stripped.stp]
2023-03-14 temp: change env, docker adjust
    [Communication.SchDoc, MotorCtrl.PcbDoc, MotorCtrl.SchDoc, Power.PcbDoc, Power.SchDoc, Top.PcbDoc]
2023-03-17 init: circuit branch
    [Bill of Materials-OWMR.csv, Communication.PcbDoc, Communication.PrjPcb, Communication.SchDoc, DE系列腳位圖_20210825.xlsx, De0 nano 腳位.xlsx, MotorCtrl.PcbDoc, MotorCtrl.PrjPcb]
2023-05-19 fix: all file not found
    [Communication.SchDoc, MotorCtrl.PcbDoc, MotorCtrl.SchDoc, Power.PcbDoc, Power.SchDoc, Top.PcbDoc]
2023-05-19 fix: all file not found issues
    [Bill of Materials-OWMR.csv, Communication.PrjPcb, MotorCtrl.PrjPcb, OWMR.PrjPcb, Pick Place for Top.csv, Power.PrjPcb, Simulation.PrjPcb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]
2023-05-25 temp: reporting
    [Bill of Materials-Main.xlsx, Bill of Materials-MotorCtrl(Not Cap Filter).csv, Bill of Materials-MotorCtrl.csv, Bill of Materials-OWMR.csv, Block Diagram.SchDoc, Communication.PrjPcb, Communication.SchDoc, Cover Page.SchDoc]
2023-06-06 add: old PCB output file
    [Bill of Materials-Main.xlsx, Bill of Materials-MotorCtrl(Not Cap Filter).csv, Bill of Materials-MotorCtrl.csv, Bill of Materials-OWMR.csv, Block Diagram.SchDoc, Communication.SchDoc, Cover Page.SchDoc, Cover Page.xlsx]
2023-06-06 add: General PCB footpoint libraries and altium pcb rules
2023-06-17 USB Type-C Power Supply Done
    [Bill of Materials-USB-C Power.csv, Bill of Materials-USB-C Power_JLCPCB.csv, MotorCtrl.SchDoc, MotorCtrl2.SchDoc, Pick Place for USB-C Power.csv, Pick Place for USB-C Power_JLCPCB.csv, Power.PrjPcb, Power.SchDoc]
2023-06-17 temp: maybe is lf and crlf issue
    [Bill of Materials-USB-C Power.csv, Bill of Materials-USB-C Power_JLCPCB.csv, Pick Place for USB-C Power.csv, Pick Place for USB-C Power_JLCPCB.csv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]
2023-09-16 review: project schematic and add Top Level design
    [Battery_Charging_and_Bypass_Power_Supply.SchDoc, Bill of Materials-USB-C Power.csv, Bill of Materials-USB-C Power_JLCPCB.csv, Block_Diagram.SchDoc, Cover_Page.SchDoc, MCU_and_Peripheral_Circuits.SchDoc, Manual_Controll_and_LEDs.SchDoc, PD_BCR_Connections.SchDoc]
2023-09-16 chore: add cover page tool and create project sch template
    [Contents.xlsx]
2023-09-16 chore: adjust workspace config and general lib
    [partition_Temp.DXF]
2023-09-16 fix: forgot to save
    [Top_Level.SchDoc, Voltage_Regulator_and_Load_Connectors.SchDoc]
2023-09-27 temp: v1 BQ connection
    [Battery_Charging_and_Bypass_Power_Supply.SchDoc, Battery_and_Bypass_Controller_Connectons.SchDoc, Block_Diagram.SchDoc, Cover_Page.SchDoc, MCU_and_Peripheral_Circuits.SchDoc, Manual_Controll_and_LEDs.SchDoc, PD_BCR_Connections.SchDoc, PD_Controll_and_LED_description.xlsx]
